luoyanglutu-pixel/SimpleKVM/硬件设计/10_软件方案.md

# 软件方案入口

2026-10-29：硬件发布基线更新为`ProPrj_SimpleKVM_2026-10-29.epro2`、`SCH_SCH_new_2026-10-29.pdf`和同日期BOM。LED、按键、CH444G控制脚及H1下载接口与既有固件映射一致；新增硬件文件没有同版本ENET，因此本次只完成PDF目视复核，未重新生成固件硬件哈希。

请阅读[软件方案 S1.0](../软件设计/01_软件方案.md)。固件按该文档实现，包括实际GPIO、四键消抖、先断后接、默认电脑4、DEV/RELEASE看门狗策略、烧录与样板验收。

旧S0.1草案未收入开源发布包。固件v0.1.1已实现并完成电脑端逻辑测试、交叉编译；请读[源码与烧录包入口](../软件设计/README.md)。5块硬件样机现均恢复基本功能，但具体固件版本、USB兼容性和长期运行仍按软件测试记录逐项验收。
