luoyanglutu-pixel/SimpleKVM/硬件设计/11_原理图复查_2026-10-20-2.md

# 更新原理图复查报告（-2版本）

> 历史报告：本文记录2026-10-20的“-2”版本，文件名和正文保留用于追溯。当前发布依据已更新为本目录中的`ProPrj_SimpleKVM_2026-10-29.epro2`、`SCH_SCH_new_2026-10-29.pdf`和同日期BOM；器件数量、DNP状态和物料结论以[README](README.md)及[05_参考资料与版本.md](05_参考资料与版本.md)为准。

历史版本V0.7；日期2026-10-20。当时接线基线为`SCH_SCH_new_2026-10-20-2.pdf`和`Netlist_SCH_new_2026-10-20-2.enet`，这两个历史输入未收入当前扁平目录。

## 1. 结论

上轮发现的选择线短接和SW2/SW4映射问题均已修正。本轮对三页PDF进行目视核对，对导出网表执行79项结构检查，全部通过，未发现同类硬连接错误。可以以此版本继续PCB设计与固件开发；打样前还应处理下列物料和电源确认项，当前不等于投产或USB认证通过。

## 2. 已修正项

| 上轮问题 | 新版实际状态 | 结论 |
| --- | --- | --- |
| U8.16/17都接MUX_SEL0 | U8.16 PC6→MUX_SEL0→KEY1.14；U8.17 PC7→MUX_SEL1→KEY1.2 | 已修正，选择信号分离 |
| SW2与SW4对应顺序错 | PD3/PD4/PD5/PD6依次接SW1/2/3/4 | 已修正 |
| 公共5V重复四颗10uF | C6/C8/C14删除，C4保留 | 公共直接标称电容41.3uF降为11.3uF |
| 四颗外部按键上拉可省 | R1～R4属性Add into BOM=no，PDF为灰色 | 默认不装，软件必须内部上拉 |

## 3. 待处理与验证

| 优先级 | 项目及证据 | 建议 / 验收条件 |
| --- | --- | --- |
| P1，打样前收敛 | F1～F4仍SMD0603-050-16，恢复电阻上限0.8Ω；Hub内部LDO要求V5≥4.5V | 以实际负载和低输入测PTC/CH213K压降，必要时选低阻PTC；不能用MCU能运行代替Hub电源达标 |
| P2，建议改图 | U6.15 V5本地C2仍100nF，已读手册引脚表建议外接1uF | 优先同位号改为1uF并靠近15脚，无需新增位号；当前图未代改 |
| P2，采购前完成 | 现有XLSX仍是旧图，保留C6/C8/C14和R1～R4装配项 | 从“-2”源工程重新导BOM；03已给新版网表提取清单供核对 |
| P2，物料确认 | 五颗10uF无完整制造商料号；X1为12MHz/CL20pF | 补齐电容耐压/介质/有效容量；实测晶体起振和频偏，默认不盲加外部电容 |
| P2，打样验证 | 四输入各10uF+公共11.3uF+Hub内部3.3V电容及外设负载 | 一路首次插入会承担本路与公共侧充电；删掉重复电容后仍需测浪涌与电源跌落 |
| P3，文档一致性 | CH444G位号KEY1；图中真值表写J1～J4，实际插座USB1～USB4 | 可规范IC位号，至少把注释连接器编号改成实际位号，避免装配/调试误认 |

PTC预算示例：300mA×0.8Ω=0.24V，加CH213K在300mA下最大压降0.08V，共0.32V。若PTC前4.75V，则公共约4.43V，尚未计走线。这是历史条件性预算，不能写成典型冷态压降或已测失败。当前保险丝料号、样机故障结论和工艺要求见[03_BOM与打样验收.md](03_BOM与打样验收.md)。

## 4. 已核对的其余关键连接

USB-C每口独立双5.1k Rd、D+/D−翻面引脚并接正确；四路VBUS逐路PTC+CH213K隔离；CH444G与Hub的上游D+/D−对应正确；三个USB-A通道及极性正确。MCU、MUX用5V，Hub VDD33独立；EN#有上拉、两个选择位有下拉；SWIO和NRST可接H1；四LED阴极接GPIO、阳极经各4.7k到5V。U6 EP库编号17接地，仍须PCB确认焊盘映射。HubRESET#/CDP、PGANG与未用第四口保持NC。

H1实际顺序为1=SWIO、2=NRST、3=GND；已同步替换旧文档的J8脚序。R1～R4按DNP处理，不能因在网表存在就统计为装配件。该历史版共59个位号、54个非空网络、55个装配件。

## 5. 已确认的成本选择及边界

按用户要求不加入数据ESD或专用电源开关，不将这两项作为本轮新增强制整改。正常按键切换只断数据，保留外设供电；源拔除和欠压仍可能复位。多电脑USB合路取电的授权/挂起行为、Hub供电属性以及外设电压要求尚未通过系统验收，现有硬件没有软件断电接口。

## 6. 可复核证据和下一步

- [当前原理图PDF](SCH_SCH_new_2026-10-29.pdf)和[当前BOM](BOM_SimpleKVM_new_SCH_new_2026-10-29.xlsx)：2026-10-29发布输入。
- [当前可编辑工程](ProPrj_SimpleKVM_2026-10-29.epro2)：包含原理图和PCB。
- [参考版本和哈希](05_参考资料与版本.md)：区分当前文件与历史检查。
- [软件方案](10_软件方案.md)：当前GPIO、按键、时序与烧录入口。

2026-10-29更新：当前目录已提供EDA工程、PCB和完整BOM，5块样机现均恢复基本功能；本文的79项脚本检查仍只对应历史网表，不能作为10月29日工程的ERC、DRC或自动连接检查结果。
