luoyanglutu-pixel/SimpleKVM/硬件设计/12_投板前审查与方案复核_2026-10-21.md

# 投板前审查与整个方案复核

> 历史报告：本文正文对应2026-10-21上午版，保留用于追溯当时的风险判断。当前发布依据为本目录2026-10-29的`.epro2`、PDF和BOM；当前物料、装配数量和样机状态以[README](README.md)、[03_BOM与打样验收.md](03_BOM与打样验收.md)及[05_参考资料与版本.md](05_参考资料与版本.md)为准。

> 后续更新：本报告对应10:47版。15:00新增Type-C的图纸审查见[13号报告](13_原理图复查_2026-10-21-2.md)。经后续讨论，主机VBUS检测按极简首版待验证的兼容性取舍记录，不再作为正常带电电脑之间按键切换的打样硬性前提；下文保留上午审查原文。该断电场景仍未由现有电路自动处理。

日期：2026-10-21。审查基线为今天10:47导出的三页原理图PDF、enet网表与BOM。用户明确“PCB我自己看”，因此本报告只对原理图连接、器件/装配信息和系统方案给结论，PCB检查由用户负责。

## 1. 投板结论

**建议先补选中电脑VBUS检测的设计/预留，并确定七颗10uF的实际物料及初装电容策略，再投第一轮功能样板。当前图没有发现上轮那类硬连接错误，但还不能按“任意电脑开关机、任意插拔均可靠”的定版电路放行。**

如果现在按原图打少量板，只能作为受控条件下的验证样机：使用已确认的5V主机端口和低功耗键鼠，先烧固件，不把数据切到VBUS已关闭的电脑，保留飞线/改件条件。这个限制不是现有固件能够自动保证的。

179项脚本检查全部通过，检查内容包括实际逐脚连接、差分对定义、BOM数量和逐位号型号一致性；另行检查的**物料完整性未通过**，因为C4/C5/C7/C9/C10/C14/C15七颗10uF没有具体制造商料号。脚本通过不等于原生ERC、实板电气或USB系统合规通过。

## 2. 今天已经修正或确认的部分

| 项目 | 当前实际状态 | 审查结论 |
| --- | --- | --- |
| F1～F4 | JK-SMD0603-050L-6，C5224376，500mA保持/1A动作，6V | 已落实国产低阻版本，接线方向未变 |
| U6 V5去耦 | C2改为1uF，接SYS_5V到GND | 上轮建议已落实；就近摆放由PCB确认 |
| 选择控制 | PC6.16→MUX_SEL0→KEY1.14；PC7.17→MUX_SEL1→KEY1.2；PD2.19→KEY1.1 EN# | 两位选择信号独立，未再出现同网短接 |
| 按键 | PD3.20、PD4.1、PD5.2、PD6.3依次接SW1～SW4 | 顺序正确；R1～R4不装，必须内部上拉 |
| LED | PC0.10～PC3.13对应LED1～LED4阴极，阳极各经4.7k到5V | 低亮高灭，正常只亮一个 |
| H1 | 1=SWIO/PD1.18；2=NRST/PD7.4；3=GND | 正确，不能套旧草稿J8线序 |
| Hub供电 | U6.15=SYS_5V；U6.16=HUB_VDD33；EP库脚17=GND | 5V和内部3.3V分离正确；EP实物映射由PCB确认 |
| Hub时钟 | X1接XI/XO，C6/C8各12pF但标DNP | 默认不装外部晶体电容，符合已读应用图原则 |
| USB-C | 每口CC1/CC2各有独立5.1k；A6/B6合D+，A7/B7合D−；四路原始VBUS独立 | 连接正确 |
| 数据通道 | 四路USB-C→CH444G→CH334P→USB5/6/7 | D+/D−极性、通道顺序正确 |
| 数据网络命名 | HUB_UP_DP/DM改为HUB_UP_D+/D−，两个端点同时修改 | 改名没有造成断网；8组差分对已定义 |
| BOM版本 | 今天XLSX与今天网表的装配集合一致 | 64个位号，58个装配件，6个DNP |

六个默认不装位号为**R1/R2/R3/R4、C6/C8**。C6/C8现在是晶体微调电容，不是昨天被删的公共10uF，不能按旧位号直接套用昨天的装配意见。USB7当前仍为装配件，第三下游口同样直供SYS_5V。

## 3. P1：选中电脑VBUS消失时，没有数据断开机制

### 具体触发条件

电脑A继续给本板供电；数据开关选在电脑B；电脑B关机且该USB口VBUS关闭，或者该口被主机切断供电。本板仍由A供电，Hub内部上拉/PHY仍有电，MCU也仍保持EN#低，数据通路继续连到B。

CH213K只隔离VBUS电源通路，不能隔离当前选中的D+/D−。因此存在对未供电主机数据口继续施加电压/电流的风险，具体回灌和异常程度取决于主机端电路，不能断言必然损坏，也不能认为“有理想二极管就已经全部防反灌”。这也是为何带其它电源来源的USB设备需要判断上游VBUS是否存在。[原厂USB设计指南关于VBUS检测的说明](https://www.silabs.com/documents/public/user-guides/UG225.pdf)

这里的判断条件是**所选端口VBUS是否存在**，不是电脑操作系统是否运行。部分电脑关机后仍保留USB 5V，VBUS检测无法区分这种待机与正常开机，也不必把待机5V误当成0V。

### 建议的最小改动方向

恢复4路独立的VBUS存在检测，信号从各自USB-C原始PC0_VBUS～PC3_VBUS引入，不能从公共SYS_5V取样，否则无法区分电脑。当前可利用U8的空闲PA1.5、PA2.6、PC4.14、PC5.15分别检测电脑1～4，保留PD1下载和PD7复位。

每路可用分压/隔离检测网络，优先预留两电阻焊盘；具体阻值必须按5V MCU的输入阈值、漏电、输入电容放电以及MCU未上电时的注入电流核算，不直接照搬3.3V MCU分压值。PA1/PA2必须关闭HSE并正确配置为GPIO，不能把Hub晶体X1误当作MCU时钟。若分压方案的断电注入或检测余量不满足，再使用小三极管隔离检测。

配套固件规则：默认EN#高；选中目标VBUS不存在就保持全断开；运行中检测到目标VBUS丢失优先拉高EN#；恢复后确认稳定，再按先断后选流程接通。用户请求的target可以保留等待，不自动跳到别的电脑。这个规则只负责有无VBUS，不声称是精密欠压检测。

**仅预留焊盘、不装器件且不改固件，不能算风险已经解决。** 现有10号软件方案描述的是“无VBUS检测”的原图版本；决定补检测后必须同步改输入初始化、接通条件和验收用例。

## 4. 整个供电架构仍有的边界

### 4.1 电源来源与数据主机分离

```text
数据：USB1～USB4 → KEY1四选一 → U6 Hub → USB5～USB7
供电：各USB-C → 各PTC → 各CH213K → 同一SYS_5V
控制：U8只决定数据目标；当前不决定哪个电脑供电
```

CH213K自动按电压及负载导通，没有协议意义上的电源优先级，也不是保证均流的四路并联电源。不能把四台电脑的额定电流简单相加作为整板能力。

可能由未选中、尚未枚举或已挂起的电脑端口承担主要电流。当前没有相应的USB配置/CC电流能力检测和源使能控制，所选电脑的Hub枚举也不能给其它电脑端口“代办取电授权”。Hub在所选主机挂起时进入低功耗，并不自动使MCU、LED和外设从实际供电源取电降到许可值。[USB-IF供电声明与挂起电流说明](https://compliance.usb.org/index.asp?UpdateFile=Electrical)

**补第3节VBUS检测只能解决无VBUS目标仍接数据的问题，不能完整解决取电授权和挂起电流。** 这些限制可在受控样机测试中明确记录；若目标是面向任意电脑的标准化产品，需要进一步确定供电策略，而不是靠一版软件把现有固定电源通路变成可控通路。

### 4.2 低压带载余量

按PTC规格书的R1max=0.4Ω上限预算；该厂家定义是回流后一小时测得的电阻上限，0.07Ω是初始最小值，均不能当作典型运行电阻。CH213K压降采用已读V1.1手册在相应电流下的最大值：

| 经过单路输入的整板总电流 | PTC预算压降 | CH213K最大压降（5V测试条件） | PTC前4.75V时SYS_5V估算 |
| --- | --- | --- | --- |
| 100mA | 0.040V | 0.040V | 4.670V |
| 200mA | 0.080V | 0.057V | 4.613V |
| 300mA | 0.120V | 0.080V | 4.550V |
| 500mA | 0.200V | 0.130V | 4.420V |

这是条件性预算，并非实测值，且未计PCB、接头、动态尖峰、温度和电源进一步下跌；CH213K参数是在指定5V条件下取得，不能当作所有输入电压下的保证。4.75V这里指**本板PTC前的测试电压**，不是主机端给4.75V再忽略USB线损。

CH334P启用内部LDO时，已读V2.91给出V5工作范围4.5～5.25V，因此目前不能承诺“500mA整板负载也稳定”。建议把**整板总负载≤200mA作为首轮样机的初始设计目标**，包括Hub、MCU、LED、键盘、鼠标及第三口；这不是经过验收的额定电流，实际允许负载以最低输入、温升和外设VBUS测试结果为准。RGB键盘、充电或大电流扩展设备不能默认支持。

PTC还会随温度降额：所选厂家表中，500mA型号在60℃/85℃的保持电流分别约340mA/210mA。需按壳内温度验证，不能把常温保持500mA当作全温恒定能力。[JK低阻系列厂家资料](https://datasheet.lcsc.com/lcsc/2210281800_Jinrui-Electronic-Materials-Co--JK-SMD0603-050L-6_C5224376.pdf)

### 4.3 多源短路不会保证四颗PTC都断开

CH213K不是没有保护：它有约1.3A典型过流限流，并在输出短路后折返到典型250mA、规格180～330mA（V1.1、25℃、5V测试条件）。单路折返电流可能低于PTC的500mA保持值，PTC不一定动作；四路都参与短路时，条件性合计约0.72～1.32A，实际还受源能力、温升和热关断影响。

因此不能宣称每个USB-A具有500mA独立限流、能识别故障口或能由固件关断。一个USB-A短路会拖低整个公共电源，Hub和MCU都可能复位。按用户极简成本选择，本报告不恢复TPS2553或数据ESD为默认件，但上述故障边界必须实测并明确保留。

### 4.4 输入上限也要确认

已读CH334 V2.91的V5推荐工作上限5.25V、绝对最大值5.5V。USB-IF的VBUS上限ECN允许到5.5V，低阻CH213K在轻载时不能把5.5V可靠降到5.25V。这里是**工作范围待厂家确认项**，不是断言会立即烧毁。[USB-IF上限更新](https://compliance.usb.org/index.asp?UpdateFile=Electrical)

本轮重新查询WCH官网，确有CH334DS1 V3.0（2026-10-19）元数据，但官方直接下载返回“请刷新页面后再重试”，未取得新版正文；不把旧版参数冒充新版结论。受控样机先用已确认的输入；产品化前应向厂家确认采购批次的实际输入工作范围，或采用能覆盖输入范围的供电方案。

## 5. 电容、BOM及装配

### 5.1 当前电容实际汇总

| 电源网络 | 当前电容 | 标称总量 |
| --- | --- | --- |
| SYS_5V | C4/C14/C15各10uF；C2/C13/C16各1uF；C3/C11各100nF | 33.2uF |
| PC0输入，PTC后/CH213K前 | C10 | 10uF |
| PC1输入，PTC后/CH213K前 | C5 | 10uF |
| PC2输入，PTC后/CH213K前 | C7 | 10uF |
| PC3输入，PTC后/CH213K前 | C9 | 10uF |
| HUB_VDD33 | C1=10uF、C12=1uF | 11uF |

第一次仅插一路供电，会给本路10uF、公共33.2uF、Hub内部3.3V电容和外设充电。其它三路输入电容因CH213K反向隔离，不能简单算成也同时被公共5V充电。LDO两侧电容也不能直接按电压相同的并联电容求和。

CH213K自身能承受一定负载电容，不等于上游USB浪涌自动合格；新增公共电容能改善瞬态保持，也会增加启动充电负担，需看实际电流波形。

建议首样把C14/C15保留焊盘、先标DNP作容量调整选项，C4保留10uF，C2/C13/C16及C3/C11按本地去耦装配，此时公共标称13.2uF。先测启动和外设热插拔，再决定加装C14/C15。**这是建议装配策略，当前原图仍把二者标为装配，不得口头省掉却不改BOM。** 它也不代表仅靠减电容就已经通过USB浪涌要求。

### 5.2 七颗10uF缺具体物料

C4/C5/C7/C9/C10/C14/C15目前只有10uF、0603，没有制造商、完整型号、耐压、介质和容差，不能把这份BOM直接交给贴片厂自行代选。选定实际料号；若用于5V，建议评估≥10V、X5R/X7R，并确认直流偏压后的有效容量及封装。C14/C15若改DNP，也仍建议给出备选料，避免后续补装混料。

C1已经选为HRE CGA0402X5R106M6R3GT，10uF/6.3V/0402，接3.3V；不能因前缀CGA就误认为TDK。C12是1uF/16V，当前两者合计11uF，未发现接错电源。0402大容量同样需关注有效容量，不能以10uF标称值代替实测。

## 6. 晶体选型和预留电容

X1目前仍为**X49SD12MSD2SC，12MHz、CL20pF、ESR50Ω、-20～70℃**，不是12pF版本。C6/C8是各12pF的DNP调试位，默认不装，方向正确。

此前倾向选CL12pF，是依据内置电容与杂散的简化模型作的选型建议，并非CH334P官方给出的兼容晶体名单，也不能据此判定现有20pF一定不能工作。当前没有晶体动参数、板级杂散、起振波形和频偏测试，结论只能是待验证。

不要因为晶体标20pF，就把C6/C8改成各20pF并默认装上；不要因为采购CL12pF晶体，就把两颗12pF预留件默认焊上。已读CH334应用说明建议不装外部振荡电容。只有按实际频偏和起振结果调整时才改变装配值，采购必须锁定具体负载规格。若产品要承诺-40～85℃，当前X1的-20～70℃范围也不覆盖，需要换对应温度等级，而不是只看MCU/Hub工业温度。

## 7. 方案功能与软件再确认

- 每台电脑一根USB数据线，四选一接入同一个Hub；三只USB-A当前都提供公共5V。键盘和鼠标会在新主机重新枚举，不是四主机同时在线的HID仿真设备。
- 当前无键盘热键切换、无纯蓝牙配对、无视频切换；2.4G USB接收器按型号验证。USB蓝牙适配器切换涉及电脑驱动和配对状态，不能等同于直接支持所有蓝牙键鼠。
- MCU使用内部HSI；Hub的X1不供MCU使用。PD5/PD6已接按键，禁用示例默认USART打印，保留PD1调试和PD7复位。
- R1～R4不装，PD3～PD6必须上拉输入；20ms消抖，一次按住只触发一次，多键序列等全部释放后再接收。
- 先写EN#高、LED全灭和选择00的锁存值，再配置输出；切换先断数据，名义100ms后写选择位，名义1ms稳定后接通。毫秒节拍有量化误差，不能把名义时间当硬件严格下限。
- 任何时刻LED只表示数据目标，不能表示USB枚举成功；加VBUS检测后，目标无VBUS时保持断开，LED需明确区分等待状态。
- 空片在EN#外部上拉作用下默认全部数据断开，**必须先烧MCU程序，才会看到Hub正常连入电脑**。USB不枚举时不要先把这个默认安全态当作接线错误。
- H1接WCH-LinkE的SWDIO/TMS、RST（可选）、GND；板子自行5V供电时，下载器5V/3V3输出均不接。ST-Link、J-Link V8和普通USB-TTL不能按现有流程直接代替。

## 8. 投第一轮样板前建议完成的最少事项

1. 决定并落实第3节的四路VBUS检测接口或至少便于改版的焊盘/引线位置；未经实现和测试前，只按受控验证样机使用。
2. 锁定七颗10uF料号，以及C14/C15是否默认DNP；明确C6/C8、R1～R4不装，避免贴片厂全装。
3. 固定采购X1的CL与温度等级，保留调试位；不要把负载规格与外接电容值混淆。
4. 整板负载按低功耗键鼠定位；先用≤200mA总负载作样机目标，不承诺第三口充电或每口500mA。
5. 由用户完成原生ERC/PCB检查与生产文件确认。当前导出网表定义了8组差分对，但未给它们绑定专用规则；这不能证明PCB已经按90Ω布好。双层1.6mm、1oz的0.28mm线宽/0.15mm线距/0.15mm同层铺地间距仅为前述参考案例，仍按板厂实际结构确认。本报告不重复要求用户提交PCB。

## 9. 样板回来后的关键验证

| 场景 | 必测内容 / 通过条件 |
| --- | --- |
| 单路最低电压带载 | PTC前4.75V；总电流100/200/300mA分档；测U6 V5、VDD33、USB-A端电压与温升。4.5V只是Hub的最低工作值，外设电压也需合格 |
| 500mA探索档 | 仅台架探索，不作为已保证的工作额定；确认是否欠压或PTC温升动作 |
| 首次插入与多源拔插 | 带/不带键鼠插入，抓输入电流和SYS_5V最低点；只拔掉主要供电源且仍有其它输入时不得异常复位 |
| A供电、B无VBUS | 关闭B端VBUS但保留数据连接；观察EN#及D+/D−，确认补检测后通路实际断开，检查B口是否受电 |
| 各主机睡眠/唤醒 | 分别测每一路电脑输入电流，而不是仅测总电流；记录供电来源与数据目标不一致时的行为 |
| 多输入短路 | 限流电源台架、受控条件下逐步测试，不先用四台电脑当短路电源；确认折返电流、温升、全部公共供电掉电及恢复行为 |
| 四通道切换 | 所有12个有向切换组合，键盘+鼠标同时接，累计至少100次；确认仅目标主机识别、按键不连发、无中间误通 |
| 晶体与外设兼容 | 测冷/热启动和频偏，避免普通大电容探头扰振；记录有线键鼠、接收器、BIOS/系统及线材型号，Type-C两种方向均验证 |
| 反向供电 | 同时测未供电输入的VBUS和所选未供电主机的数据线，不把测完VBUS就等同于全部防反灌通过 |

## 10. 输入、证据和版本

| 原始输入 | SHA-256 |
| --- | --- |
| `SCH_SCH_new_2026-10-21.pdf`（历史10:47版，发布包未收录） | `56f35b37c3b4456cb39b8ed90363ab9fe9f384a6e4081a01c73770480408a060` |
| `Netlist_SCH_new_2026-10-21.enet`（历史10:47版，发布包未收录） | `09a54218a19713226b62612a7be57d9fdd1842a46c87a3337d1769538bdfac52` |
| `BOM_SimpleKVM_new_SCH_new_2026-10-21.xlsx`（历史10:47版，发布包未收录） | `99992025ffda80f9c54d54df6f69f16dc4ad522f2ecfe116fece7ac18d0286a0` |

本节记录的是历史10:47版审查输入。当前目录已改为2026-10-29扁平发布结构；历史数量不得用于当前采购。当前原理图为67个位号、60个默认装配器件和7个DNP，详见03和05号文档。

本地手册依据：CH334DS1 V2.91第3页功能对比、第19页电气、第26页振荡与应用；CH213DS1 V1.1第2～3页方向和电气、第5页启动；CH32V003DS0 V1.0第9页脚号、第13/19页输入与注入限制；CH440DS1 3E的CH444G引脚和真值表。当前发布包不再包含历史审查附件，采购前应从原厂重新取得适用版本。

本文只作为历史记录。2026-10-29版保持软件核心GPIO不变，已提供PCB工程和完整BOM，5块样机现均恢复基本功能；仍未完成USB认证、ESD/EMC和批量一致性验证。
