luoyanglutu-pixel/SimpleKVM/docs/版本与资料范围.md

# 版本与资料范围

开源包整理日期：2026-10-29。

## 发布基线

| 模块 | 基线 |
| --- | --- |
| 硬件连接 | `SCH_SCH_new_2026-10-29.pdf`与同日期BOM |
| 可编辑EDA工程 | `ProPrj_SimpleKVM_2026-10-29.epro2`，嘉立创EDA专业版4.1.78，含3页原理图和1块PCB |
| 固件 | v0.1.1，默认PC4/LED4 |
| MCU | CH32V003F4P6 |
| USB数据开关 | CH444G |
| USB Hub | CH334P |
| 结构 | 当前目录现有SolidWorks、STL和3MF集合 |

## 网表与历史审查资料

当前目录没有2026-10-29版ENET网表。`04_引脚连接清单.json`以及11～13号审查报告记录的是2026-10-20至21日的历史基线，只用于追溯，不能代替当前工程重新导出的网表。

当前关键GPIO、USB端口和主要电源连接已按10月29日PDF目视复核。复刻或修改设计时，应从当前`.epro2`工程重新导出同版本网表、Gerber、钻孔和贴片坐标，并重新执行ERC/DRC及固件映射检查。

当前发布文件的逐文件哈希见仓库根目录`SHA256SUMS.txt`。哈希只能用于确认文件内容是否改变，不等于已在嘉立创EDA中完成导入、ERC或DRC。

## 验证边界

- 固件23项主机端逻辑测试通过。
- 三种固件配置交叉编译通过。
- 历史原理图导出网表与固件GPIO掩码检查通过；该结论不自动覆盖10月29日版工程。
- `.epro2`归档包含3页原理图和1块PCB；发布前仍应在嘉立创EDA专业版中打开并运行ERC/DRC。
- 5块样机均已恢复基本功能；此前3块异常确认与回流焊后0603自恢复保险丝损坏、阻值异常有关。
- 上述检查不等于PCB DRC、USB协议兼容性、阻抗、ESD、EMC、温升或批量生产验证。
