luoyanglutu-pixel/SimpleKVM/硬件设计/02_原理图设计指导.md

# 原理图设计指导与接线基线

版本V1.0；更新日期2026-10-29。接线基线为`SCH_SCH_new_2026-10-29.pdf`，可编辑工程为`ProPrj_SimpleKVM_2026-10-29.epro2`。

当前目录没有同版本ENET网表。以下内容来自三页PDF目视核对；`04_引脚连接清单.json`是2026-10-20历史导出，不能作为10月29日工程的自动校验结果。

## 1. 四个电脑侧USB-C输入

USB1～USB4分别对应电脑1～4和内部PC0～PC3。每个接口的A6/B6并到本口D+，A7/B7并到本口D−，A4/A9/B4/B9并到本口VBUS。CC1和CC2各用独立5.1kΩ下拉电阻，位号为R13～R20；两个CC脚不能短接。

四路电源按下表进入SYS_5V：

| 电脑 / 接口 | 原始VBUS | 保险丝 | CH213K | 输入侧10uF |
| --- | --- | --- | --- | --- |
| 电脑1 / USB1 | PC0_VBUS | F1 | U2 | C10 |
| 电脑2 / USB2 | PC1_VBUS | F2 | U1 | C5 |
| 电脑3 / USB3 | PC2_VBUS | F3 | U3 | C7 |
| 电脑4 / USB4 | PC3_VBUS | F4 | U4 | C9 |

每路由电脑VBUS经过保险丝进入CH213K的VI+，CH213K的VO−汇合到SYS_5V，1脚接GND。VO−是器件库中的引脚名称，不表示该脚接地。

当前数据线直接进入CH444G，没有默认串联电阻和专用ESD器件。这是极简成本版本的明确边界；普通小电阻不能替代ESD钳位。

## 2. KEY1：CH444G

| 脚号 | 名称 | 当前网络 |
| --- | --- | --- |
| 1 | EN# | MUX_EN_N |
| 2 | IN1 | MUX_SEL1 |
| 3 | S4A | PC3_D+ |
| 4 | S3A | PC2_D+ |
| 5 | S2A | PC1_D+ |
| 6 | S1A | PC0_D+ |
| 7 | YA | HUB_UP_D+ |
| 8 | GND | GND |
| 9 | YB | HUB_UP_D− |
| 10 | S1B | PC0_D− |
| 11 | S2B | PC1_D− |
| 12 | S3B | PC2_D− |
| 13 | S4B | PC3_D− |
| 14 | IN0 | MUX_SEL0 |
| 15 | NC | 不连接 |
| 16 | VCC | SYS_5V |

R9=10kΩ将EN#上拉到SYS_5V；R10、R11各100kΩ，将SEL0、SEL1下拉到GND。C11=100nF贴近KEY1供电脚。切换时先将EN#拉高，更新IN1/IN0，等待稳定后再拉低EN#。

| 目标电脑 | EN# | IN1 | IN0 | 上游接口 |
| --- | --- | --- | --- | --- |
| 电脑1 | 0 | 0 | 0 | USB1 |
| 电脑2 | 0 | 0 | 1 | USB2 |
| 电脑3 | 0 | 1 | 0 | USB3 |
| 电脑4 | 0 | 1 | 1 | USB4 |
| 全断开 | 1 | 任意 | 任意 | 只断数据，不断SYS_5V |

## 3. U6：CH334P四口Hub

| U6脚号 | 名称 | 网络 / 用途 |
| --- | --- | --- |
| 1 / 2 | XO / XI | X1 12MHz晶体 |
| 3 / 4 | DM4 / DP4 | HD3_D− / HD3_D+，到USB7 |
| 5 / 6 | DM3 / DP3 | HD2_D− / HD2_D+，到USB6 |
| 7 / 8 | DM2 / DP2 | HD1_D− / HD1_D+，到USB5 |
| 9 / 10 | DM1 / DP1 | HD0_D− / HD0_D+，到USB8 |
| 11 / 12 | DMU / DPU | HUB_UP_D− / HUB_UP_D+，来自CH444G |
| 13 | RESET#/CDP | 不连接 |
| 14 | PGANG | 不连接 |
| 15 | V5 | SYS_5V，C2=1uF到地 |
| 16 | VDD33 | HUB_VDD33，C12=1uF到地 |
| 17 / EP | GND | 必须在PCB封装中可靠接地 |

X1为12MHz、HC-49US封装，当前料号`X49SD12MSD2SC`。C6、C8标注12pF但默认不装，使用CH334P内部振荡负载。若更换晶体，应重新核对负载电容、起振裕量和频偏，不能只按频率替换。

C1=10uF作为Hub附近SYS_5V电容；C2和C12均为1uF。HUB_VDD33是CH334P内部LDO输出，不连接SYS_5V，也不用于给MCU供电。

## 4. 四个下游接口

| Hub端口 | U6数据脚 | 网络 | 外部接口 | VBUS |
| --- | --- | --- | --- | --- |
| 第1路 | 9 DM1 / 10 DP1 | HD0_D− / HD0_D+ | USB8 Type-C | SYS_5V常供电 |
| 第2路 | 7 DM2 / 8 DP2 | HD1_D− / HD1_D+ | USB5 Type-A | SYS_5V |
| 第3路 | 5 DM3 / 6 DP3 | HD2_D− / HD2_D+ | USB6 Type-A | SYS_5V |
| 第4路 | 3 DM4 / 4 DP4 | HD3_D− / HD3_D+ | USB7 Type-A | SYS_5V |

USB8的A6/B6并为D+，A7/B7并为D−。CC1、CC2分别通过R21、R22各56kΩ上拉SYS_5V，表示默认USB电流档。USB8没有CC检测和VBUS开关，因此只作为已知低功耗USB2.0外设口使用；不要连接另一台电脑、供电扩展坞或其它可能向VBUS反向供电的设备。

USB5～USB7的2脚为D−、3脚为D+、4脚及外壳脚接GND。四个下游口可同时插外设，但共享同一个SYS_5V电源预算。

## 5. U8：CH32V003F4P6

| 功能 | GPIO | 芯片脚号 | 网络 | 说明 |
| --- | --- | --- | --- | --- |
| LED1～LED4 | PC0～PC3 | 10～13 | PC0_LED～PC3_LED | 低电平点亮 |
| SW1～SW4 | PD3～PD6 | 20、1、2、3 | PC0_SWI～PC3_SWI | 内部上拉，按下接地 |
| MUX_SEL0 | PC6 | 16 | MUX_SEL0 | CH444G IN0 |
| MUX_SEL1 | PC7 | 17 | MUX_SEL1 | CH444G IN1 |
| MUX_EN_N | PD2 | 19 | MUX_EN_N | CH444G EN# |
| SWIO | PD1 | 18 | SWIO | 单线下载 |
| NRST | PD7 | 4 | NRST | R12=10kΩ上拉 |
| 电源 | VDD / VSS | 9 / 7 | SYS_5V / GND | MCU直接使用5V |

C3=100nF、C13=1uF为MCU供电去耦，C15=10uF保留但默认不装。R1～R4为外部按键上拉预留，默认不装；固件必须开启PD3～PD6内部上拉。R5～R8各4.7kΩ，从SYS_5V经LED接到PC0～PC3，GPIO低电平点亮。

固件使用内部HSI，不使用板上X1。保留PD1调试和PD7复位功能，不要启用占用PD5/PD6的串口打印初始化。

## 6. H1下载接口

| H1脚号 | 网络 | MCU | WCH-LinkE |
| --- | --- | --- | --- |
| 1 | SWIO | PD1 / 18脚 | SWDIO/TMS |
| 2 | NRST | PD7 / 4脚 | RST，可选 |
| 3 | GND | VSS / 7脚 | GND |

目标板由USB或限流5V电源供电时，不连接WCH-LinkE的3.3V或5V输出，也不连接SWCLK。H1不是下载器排针的物理直通定义，必须按网络名接线。烧录步骤见[08_下载接口与烧录指南.md](08_下载接口与烧录指南.md)。

## 7. PCB与生产检查

- 在嘉立创EDA专业版中执行ERC和DRC，确认U6 EP、U8、KEY1和所有USB连接器的1脚方向与封装。
- USB 2.0差分对按板厂叠层计算约90Ω差分阻抗，连续参考地、成对、短、少过孔，不跨地缝。
- CH444G至U6的上游对以及4个电脑支路避免长支线；X1靠近U6并远离USB和控制走线。
- PTC和CH213K电源铜皮按实际电流、压降和温升设计。F1～F4回流后必须测量冷态阻值。
- 当前目录没有Gerber、钻孔、贴片坐标和同版本ENET网表；不能仅凭PDF完成生产放行。

物料和实板测试见[03_BOM与打样验收.md](03_BOM与打样验收.md)。
