luoyanglutu-pixel/SimpleKVM/硬件设计/05_参考资料与版本.md

# 参考资料与版本记录

版本V1.0；更新日期2026-10-29。

## 1. 当前发布输入

| 文件 | 用途 | SHA-256 |
| --- | --- | --- |
| [ProPrj_SimpleKVM_2026-10-29.epro2](ProPrj_SimpleKVM_2026-10-29.epro2) | 嘉立创EDA专业版4.1.78可编辑工程，含SCH、3个SCH_PAGE和PCB | `e9788795cc1f5868b95208a61531f9a7a6e04f5df2975a7832593e5f73e33620` |
| [SCH_SCH_new_2026-10-29.pdf](SCH_SCH_new_2026-10-29.pdf) | 三页原理图PDF | `2a0472c722191a3ec380d78114c99a1b42fed6ea0d62099289b459ac37409519` |
| [BOM_SimpleKVM_new_SCH_new_2026-10-29.xlsx](BOM_SimpleKVM_new_SCH_new_2026-10-29.xlsx) | 20个物料行、60个默认装配器件 | `8ed492aca8bc979d2edb6fc583e5668d9446db59df8c7a54627b02a527e63dc3` |

PDF文件于2026-10-29导出，但图框中的创建/更新日期仍显示2026-10-21或2026-10-22。该图框日期没有随导出更新，不能单独用来判断发布版本；公开发布以文件名、文件哈希和本记录为准。

当前目录没有2026-10-29同版本ENET网表。`04_引脚连接清单.json`以及11～13号报告属于2026-10-20至21日历史审查资料。当前GPIO、USB端口和主要电源连接已按新PDF目视复核，但没有对新版工程重新执行网表脚本检查，也没有在本轮通过嘉立创EDA图形界面重新运行ERC/DRC。

## 2. 当前物料与装配变化

- 4路保险丝明确为`JK-SMD0603-050L-6`，商城编号C5224376。
- 7颗默认装配10uF电容均已有具体制造商料号；C1为0402，其余C4、C5、C7、C9、C10、C14为0603。
- C2已为1uF，C12、C13、C16同为1uF。
- R21、R22为56kΩ，用于USB8 Type-C的CC1/CC2上拉。
- R1～R4、C6、C8、C15共7项默认不装。
- BOM总数为20个物料行、60个默认装配器件；原理图共67个位号。

## 3. 原厂资料入口

- [CH334手册](https://www.wch.cn/downloads/CH334DS1_PDF.html)：Hub引脚、电源、振荡器和应用电路。
- [CH440系列手册](https://www.wch.cn/downloads/CH440DS1_PDF.html)：CH444G引脚和选择真值表。
- [CH213手册](https://www.wch.cn/downloads/CH213DS1_PDF.html)：电源方向、压降和工作条件。
- [CH32V003资料](https://www.wch.cn/products/CH32V003.html)：TSSOP20脚号、5V供电和GPIO参数。
- [WCH-Link产品页](https://www.wch.cn/products/wch-link)：下载器型号和支持范围。
- [WCH-LinkUtility](https://www.wch.cn/downloads/WCH-LinkUtility_ZIP.html)：固件下载工具。

第三方数据手册未随本目录重新分发。采购、替代料和量产前应从原厂获取与实际型号、批次相符的最新手册，不应只依赖历史审查中的旧版页码。

## 4. 固件依据

固件使用CH32V003F4P6、内部HSI和PD1/SWIO单线下载。应用代码、固定WCH SDK来源、构建和测试记录位于相邻的`软件设计`目录。当前10月29日原理图保持以下核心映射：

- PC0～PC3：LED1～LED4，低电平点亮；
- PD3～PD6：SW1～SW4，内部上拉；
- PC6、PC7、PD2：MUX_SEL0、MUX_SEL1、MUX_EN_N；
- PD1、PD7：SWIO、NRST。

由于当前未导出同版本ENET，固件硬件校验脚本仍只证明历史网表基线；发布前如修改上述映射，应先导出新版网表并更新校验哈希。

## 5. 历史文件说明

11、12、13号Markdown保留早期审查过程和设计取舍，用于追溯，不是当前采购或生产依据。若历史报告中的器件数量、DNP状态、电容料号或输入文件与本文件冲突，以2026-10-29的`.epro2`、PDF、BOM和本记录为准。
