luoyanglutu-pixel/SimpleKVM/硬件设计/13_原理图复查_2026-10-21-2.md

# 2026-10-21下午版原理图复查

> 历史报告：本文记录2026-10-21下午版及当时的BOM统计。当前发布依据为本目录中的2026-10-29`.epro2`、PDF和BOM；当前为67个位号、60个默认装配器件、7个DNP。下文保留用于追溯Type-C下游口的设计过程，不作为当前采购清单。

历史审查对象：15:00导出的`SCH_SCH_new_2026-10-21-2.pdf`、`Netlist_SCH_new_2026-10-21-2.enet`和同版BOM；这些历史输入未收入当前扁平目录。当时对照10:47版逐页核对三页PDF、连接和BOM，PCB不在该次结论内。

## 1. 结论

**新增Type-C的数据和CC电阻接线正确，没有发现本次修改引入的硬连接错误。** 当前为3个USB-A和1个USB-C独立下游口，不是把A/C插座并接在同一路；可以同时连接外设。四台电脑仍由CH444G选一路，再经CH334P扩展到四个外设。

本版沿用VBUS常供电的极简下游Type-C接法，没有CC接入检测、受控VBUS开关或输出反灌隔离，因此不能按完整符合Type-C要求的通用接口定版。低功耗、固定键鼠的首版验证与通用接口量产应分开判断；误接其他电源、电脑供电口或有供电功能的扩展坞，可能形成输出端电源互连。

上午报告将主机VBUS检测列为先补再打样，后续讨论已澄清：它不妨碍正常带电电脑之间的按键切换。本次按极简首版的功能边界记录，不要求为功能打样自动增加电路；目标主机断电后的数据隔离仍未实现，不代表风险已经消失。VBUS常有5V也不等于电脑操作系统已经运行。

389项连接、变更范围、装配及BOM一致性断言通过。这个数包括逐位号料号、数值、封装和供应商编码核对，不是389项电气性能测试。**物料完整性仍不通过：七颗10uF未定料号。** 未执行原生EDA ERC、PCB检查、固件编译/烧录或样板测试。

## 2. 本次实际改动

- 新增USB8，型号KH-TYPE-C-16P，供应商编码C709357，加入BOM。
- 新增R21、R22，各56kΩ、1%、0402，FRC0402F5602TS，C2906875，均加入BOM。
- U6的第4路DM4/DP4从悬空改为接USB7。原有USB5、USB6的数据各后移一组，第1路改接新USB8。
- 原有器件的有效规格、物料型号和DNP状态未改变；导出增加的PCB Layer=Default属性不视为电路改动。
- 该历史版有67个位号、61个默认装配、6个DNP、58个非空网络和9组差分对；BOM为20个物料行，包含新增插座和电阻。

## 3. 四个独立下游口的实际分配

| Hub端口 | U6 D+脚 | U6 D-脚 | 网络 | 外部插座 |
| --- | --- | --- | --- | --- |
| 第1路 | 10 DP1 | 9 DM1 | HD0_D+/HD0_D- | USB8 Type-C |
| 第2路 | 8 DP2 | 7 DM2 | HD1_D+/HD1_D- | USB5 Type-A |
| 第3路 | 6 DP3 | 5 DM3 | HD2_D+/HD2_D- | USB6 Type-A |
| 第4路 | 4 DP4 | 3 DM4 | HD3_D+/HD3_D- | USB7 Type-A |

这与先前建议“Type-C接第4路”的编号不同，但功能等效，当前连接没有问题。四个口没有并接D+/D-，没有极性反接，也没有把Type-C接到电脑上游选择通道。

## 4. USB8逐项核对

| 项目 | 实际连接 | 判断 |
| --- | --- | --- |
| D+ | A6、B6合并，HD0_D+，接U6.10 | 正确 |
| D- | A7、B7合并，HD0_D-，接U6.9 | 正确 |
| CC1 | A5经R21 56kΩ上拉SYS_5V | Source端默认电流Rp方向正确 |
| CC2 | B5经R22 56kΩ上拉SYS_5V | 独立Rp，未与CC1短接 |
| VBUS | A4/A9/B4/B9全部直接接SYS_5V | 电源脚齐全，但恒带电 |
| 地 | A1/A12/B1/B12及四个外壳脚均GND | 连接完整 |
| SBU | A8、B8悬空 | 普通USB2.0用途正确 |
| 差分定义 | HD0_D与HD3_D等9组定义齐全 | 正负网络匹配，不代替PCB阻抗检查 |

CC1/CC2各上拉56kΩ表示默认USB供电档，不是1.5A或3A。该电阻不做限流，不会增加整机的实际电流预算。SYS_5V经过保险丝和理想二极管会有压降，负载测试同时要观察Type-C供电电压；低于驱动Rp所要求的供电范围不能按标准端口宣称。

参考：[乐鑫USB Type-C硬件指南](https://docs.espressif.com/projects/esp-iot-solution/en/latest/usb/usb_overview/usb_typec_hardware_guide.html)、[TI CC控制器选型指南](https://www.ti.com/lit/an/sdaa284/sdaa284.pdf)、[TI下游Type-C VBUS控制说明](https://e2e.ti.com/support/interface-group/interface/f/interface-forum/1324014/faq-how-to-control-vbus-on-a-usb-c-port)。最后一项本轮网页读取受限，沿用前次已检索的官方说明，不作为本轮新取得的全文。

## 5. 首版保留的限制和装配事项

### 5.1 新增C口的电源角色

标准下游C口需要根据CC检测确认受电设备接入，再开启VBUS，断开后关闭；无需为了普通5V键鼠引入PD快充。当前R21/R22仅建立Rp，不能执行检测、开关或防反灌。

首版若按当前极简图制作，应将USB8标识为键鼠外设口，并在已确认的低功耗外设上验证。插座外壳标称3A只是连接器能力，不是整机输出能力。充电器、另一台电脑、手机充电负载或带供电的扩展坞不属于已验证用途。输入侧F1～F4/CH213K不等同于新增输出口的隔离开关。

若要求通用Type-C兼容性，后续应补CC检测、VBUS通断及适当的反向电流控制；本次没有选定或实际添加这些电路。

### 5.2 装配清单

- R1/R2/R3/R4、C6/C8继续DNP，当前BOM确实排除它们。按键需启用MCU内部上拉；晶体电容不应仅因晶体CL=20pF就直接装上。
- C4/C5/C7/C9/C10/C14/C15仍只有10uF、0603，无完整料号。确定耐压、介质和直流偏压后的有效电容，再给贴片厂最终物料表。5V线上可优先核对10V及以上的X5R/X7R具体型号。
- C14/C15目前仍是FIT，并未采纳上午提出的首版DNP建议。SYS_5V直接并联标称33.2uF未变。是否不装应在装配单上明确；若两颗均不装，名义公共电容为13.2uF，不含HUB_VDD33和各隔离输入侧电容。
- 不建议为新C口再无条件增加大电容。当前总电容、电缆和外设输入电容的插入冲击需一起测。

### 5.3 整机供电和主机状态

- F1～F4仍是JK-SMD0603-050L-6低阻版本，输入各自经过CH213K合路，接法未变。
- 四个下游口共用SYS_5V；增加一个接口没有增加可用电流。上午报告的低压余量、合路取电和共用短路影响仍适用，不能承诺每口500mA。
- 首轮可从整机含板载及全部外设约200mA以内的验证目标开始；该数是测试目标，不是已测额定值或USB合规供电承诺。
- 没有主机VBUS检测：另一台电脑给板子供电时，所选电脑端口断电后仍可能接着数据。首版按讨论保留此边界；按键操作不能自动识别选中主机之后的断电。
- 四路长期合路输入的供电授权、挂起电流和故障行为仍需验证，不能仅凭数据能识别就认为全部满足USB电气要求。

## 6. 切换控制和软件

本次未改变CH444G或MCU连接。PC6.16接MUX_SEL0，PC7.17接MUX_SEL1，PD2.19接MUX_EN_N。两位选择线独立，EN#有10k上拉，默认关闭数据。PD3～PD6接SW1～SW4；PC0～PC3接LED1～LED4，低电平点亮。H1仍为1 SWIO、2 NRST、3 GND。

增加Hub第4路外设无需修改按键选电脑的映射，Hub自行处理枚举。软件仍要先断开MUX、更新选择、等待稳定后再接通，避免直接带使能翻转选择位。LED只表示所选通道，不能代表外设已成功枚举。空白MCU没有切换功能，样板首次识别前需烧录固件。

## 7. 新增接口样板验收

1. 先用已知5V限流电源检查静态电流、SYS_5V和HUB_VDD33，再连接电脑。
2. USB8接已知低功耗USB2.0外设，用普通USB2.0 C-C线正反插分别检查识别和工作；不能只测一个方向。
3. USB8与三个USB-A同时连接低功耗外设，逐一确认四个Hub端口，检查四台电脑的所有目标切换。
4. 用实际线缆记录满载电流和最低SYS_5V/插座VBUS，检查插拔、切换和供电电脑退出时有无复位。
5. 检查选中主机USB供电关闭、其他主机仍供电的情况，记录反向电流/异常供电；不以“关机但VBUS仍有5V”代替此测试。
6. Type-C常供电方案的误接其他电源场景，如需验证，应使用可控限流台架，不用电脑端口作为短路或电源对冲的测试源。

## 8. 当前资料与范围

- [当前原理图PDF](SCH_SCH_new_2026-10-29.pdf)
- [当前BOM](BOM_SimpleKVM_new_SCH_new_2026-10-29.xlsx)
- [当前可编辑工程](ProPrj_SimpleKVM_2026-10-29.epro2)
- [上午供电计算和整体方案复核](12_投板前审查与方案复核_2026-10-21.md)：历史输入为10:47版本。

2026-10-29版仍保留3个USB-A和1个USB-C独立下游口，R21/R22为56kΩ，USB8常供电边界不变。当前没有同版本ENET网表，不能沿用本报告的历史自动检查数量宣称新版已通过网表验证；PCB还需在EDA中执行ERC/DRC、封装和差分线检查。
