luoyanglutu-pixel/SimpleKVM/结构设计/外观渲染/2026-10-23_烟灰半透方案_v1.png

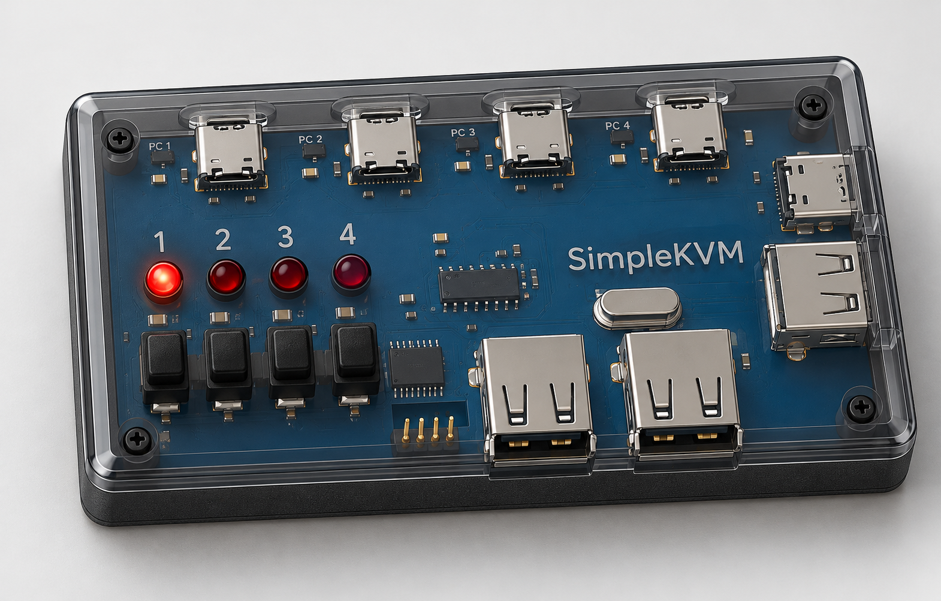
结构设计/外观渲染/2026-10-23_烟灰半透方案_v1.png
