luoyanglutu-pixel/SimpleKVM/软件设计/烧录工具.png

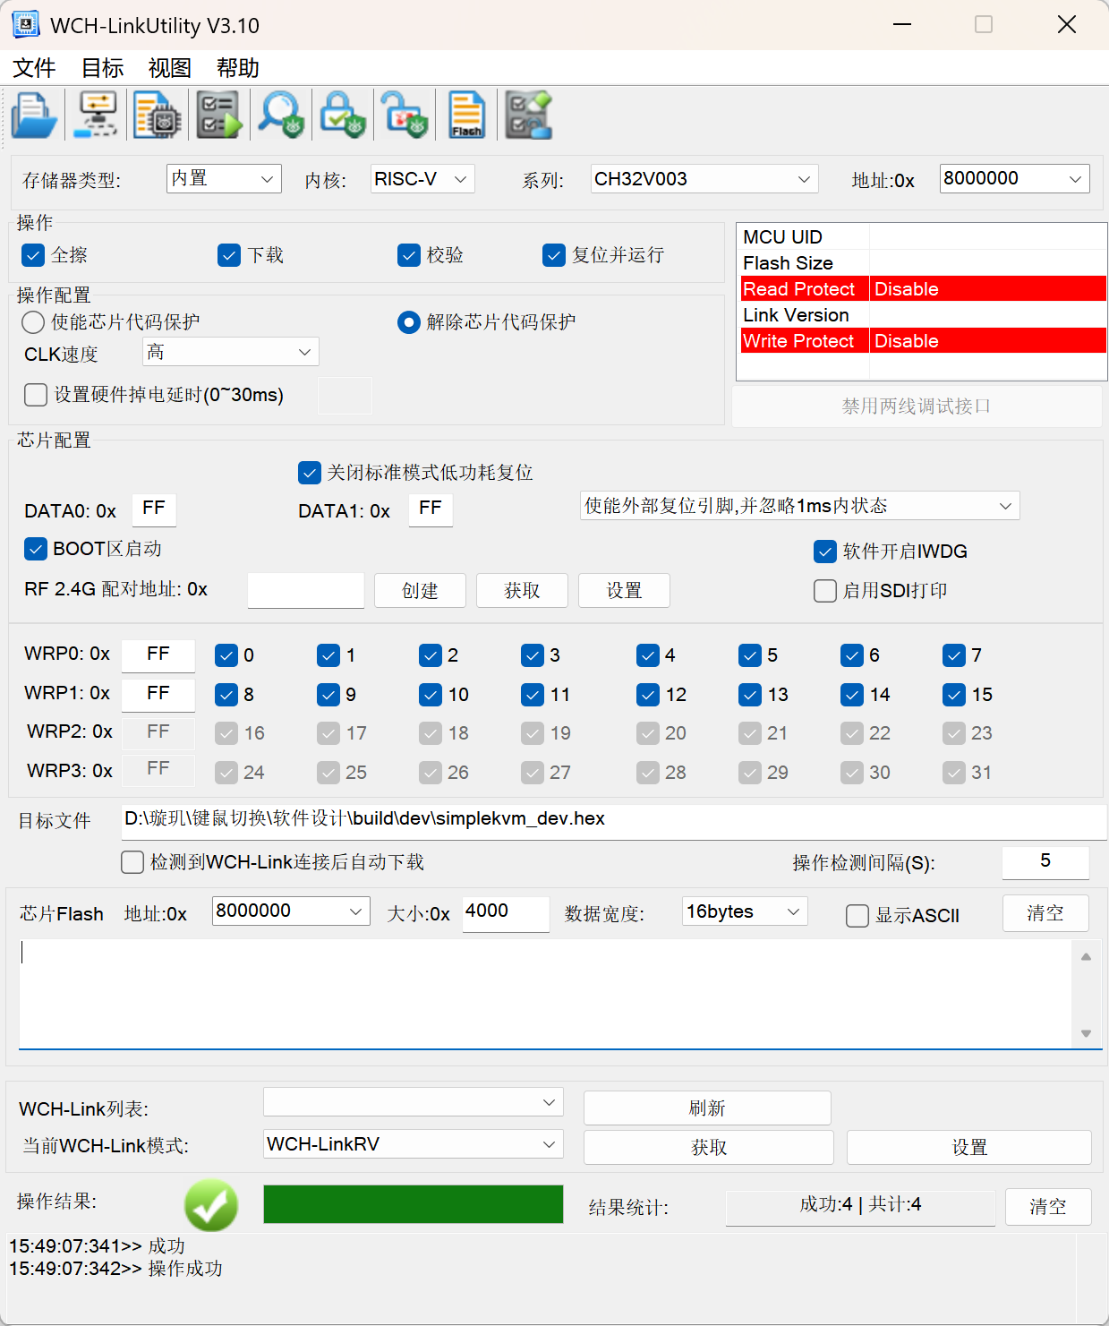
软件设计/烧录工具.png
