luoyanglutu-pixel/SimpleKVM/硬件设计/BOM_SimpleKVM_new_SCH_new_2026-10-29.xlsx

No. | Quantity | Comment | Designator | Footprint | Value | Manufacturer Part | Manufacturer | Supplier Part | Supplier | Add into BOM
1 | 1 | 10uF | C1 | C0402 | 10uF | CGA0402X5R106M6R3GT | HRE(芯声) | C23692971 | LCSC | yes
2 | 4 | 1uF | C2,C12,C13,C16 | C0402 | 1uF | CL05A105KO5NNNC | SAMSUNG(三星) | C29266 | LCSC | yes
3 | 2 | 100nF | C3,C11 | C0402 | 100nF | FCC0402B104K160AT | FOJAN(富捷) | C5137468 | LCSC | yes
4 | 6 | 10uF | C4,C5,C7,C9,C10,C14 | C0603 | 10uF | CGA0603X5R106K100JT | HRE(芯声) | C6119842 | LCSC | yes
5 | 4 | JK-SMD0603-050L-6 | F1,F2,F3,F4 | F0603 |  | JK-SMD0603-050L-6 | JK(金科) | C5224376 | LCSC | yes
6 | 1 | LAIL-PZ2.54-3P-L | H1 | HDR-TH_3P-P2.54-V-M-1 |  | LAIL-PZ2.54-3P-L | LAILAN(莱联) | C54950604 | LCSC | yes
7 | 1 | CH444G | KEY1 | SOP-16_L10.0-W3.9-P1.27-LS6.0-BL |  | CH444G | WCH(南京沁恒) | C86413 | LCSC | yes
8 | 4 | XL-502SURD | LED1,LED2,LED3,LED4 | LED-TH_BD5.9-P2.54-RD_RED |  | XL-502SURD | XINGLIGHT(成兴光) | C2895492 | LCSC | yes
9 | 4 | 4.7kΩ | R5,R6,R7,R8 | R0402 | 4.7kΩ | 0402WGJ0472TCE | UNI-ROYAL(厚声) | C25940 | LCSC | yes
10 | 2 | 10kΩ | R9,R12 | R0402 | 10kΩ | FRC0402J103 TS | FOJAN(富捷) | C2906885 | LCSC | yes
11 | 2 | 100kΩ | R10,R11 | R0402 | 100kΩ | 0402WGF1003TCE | UNI-ROYAL(厚声) | C25741 | LCSC | yes
12 | 8 | 5.1kΩ | R13,R14,R15,R16,R17,R18,R19,R20 | R0402 | 5.1kΩ | FRC0402F5101TS | FOJAN(富捷) | C2906874 | LCSC | yes
13 | 2 | 56kΩ | R21,R22 | R0402 | 56kΩ | FRC0402F5602TS | FOJAN(富捷) | C2906875 | LCSC | yes
14 | 4 | TS-1101-C-W | SW1,SW2,SW3,SW4 | SW-SMD_L6.0-W3.3-LS8.0 |  | TS-1101-C-W | XKB Connectivity(中国星坤) | C318938 | LCSC | yes
15 | 4 | CH213K | U1,U2,U3,U4 | SOT-23-3_L2.9-W1.6-P1.90-LS2.8-BR |  | CH213K | WCH(南京沁恒) | C5456874 | LCSC | yes
16 | 1 | CH334P | U6 | QFN-16_L3.0-W3.0-P0.50-BL-EP1.7 |  | CH334P | WCH(南京沁恒) | C5373042 | LCSC | yes
17 | 1 | CH32V003F4P6 | U8 | TSSOP-20_L6.5-W4.4-P0.65-LS6.4-BL |  | CH32V003F4P6 | WCH(南京沁恒) | C5187096 | LCSC | yes
18 | 5 | KH-TYPE-C-16P | USB1,USB2,USB3,USB4,USB8 | USB-C-SMD_KH-TYPE-C-16P |  | KH-TYPE-C-16P | kinghelm(金航标) | C709357 | LCSC | yes
19 | 3 | USB-231-ARY | USB5,USB6,USB7 | USB-A-TH_USB-231-ARY |  | USB-231-ARY | XUNPU(讯普) | C720525 | LCSC | yes
20 | 1 | 12MHz | X1 | HC-49US_L11.5-W4.5-P4.88 | 12MHz | X49SD12MSD2SC | YXC(扬兴晶振) | C16369 | LCSC | yes
