luoyanglutu-pixel/SimpleKVM/结构设计/打印件/按键2-4.3mf

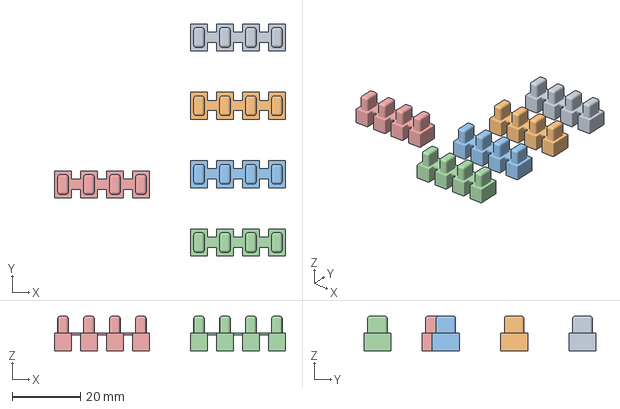
[picture p5: CAD file, 2026-10-30]
结构设计/打印件/按键2-4.3mf
67.6 x 68.0 x 10.2 mm
按键2-4 x 5
