luoyanglutu-pixel/SimpleKVM/结构设计/按键2.SLDPRT

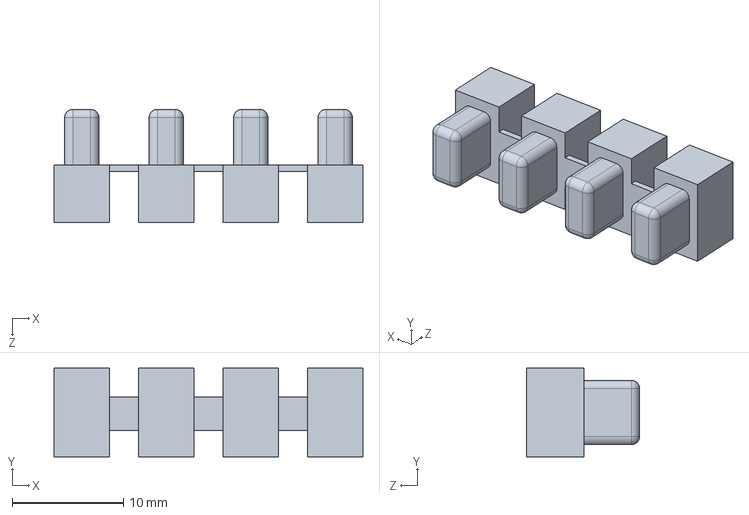
[picture p6: CAD file, 2026-10-30]
结构设计/按键2.SLDPRT
27.8 x 8.00 x 10.2 mm
