luoyanglutu-pixel/SimpleKVM/结构设计/打印件/后盖.3mf

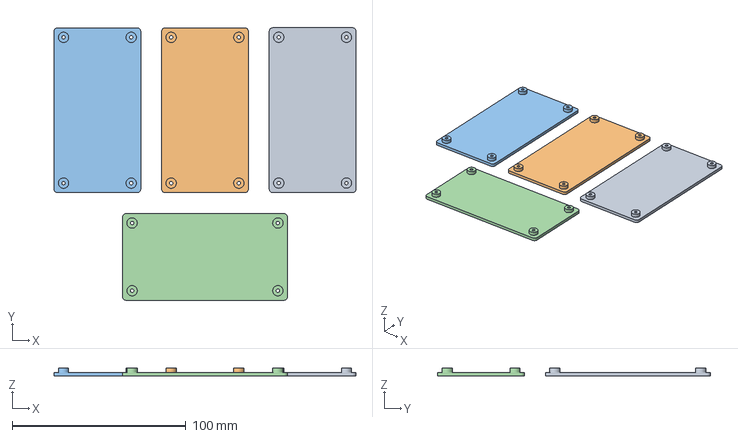
[picture p7: CAD file, 2026-10-30]
结构设计/打印件/后盖.3mf
174.0 x 157.0 x 4.40 mm
后盖 x 4
