luoyanglutu-pixel/SimpleKVM/结构设计/打印件/上壳-3.3MF

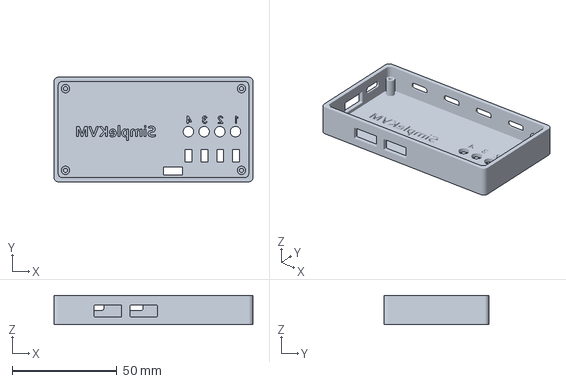
[picture p8: CAD file, 2026-10-30]
结构设计/打印件/上壳-3.3MF
95.0 x 50.0 x 14.0 mm
