luoyanglutu-pixel/SimpleKVM/结构设计/后盖.SLDPRT

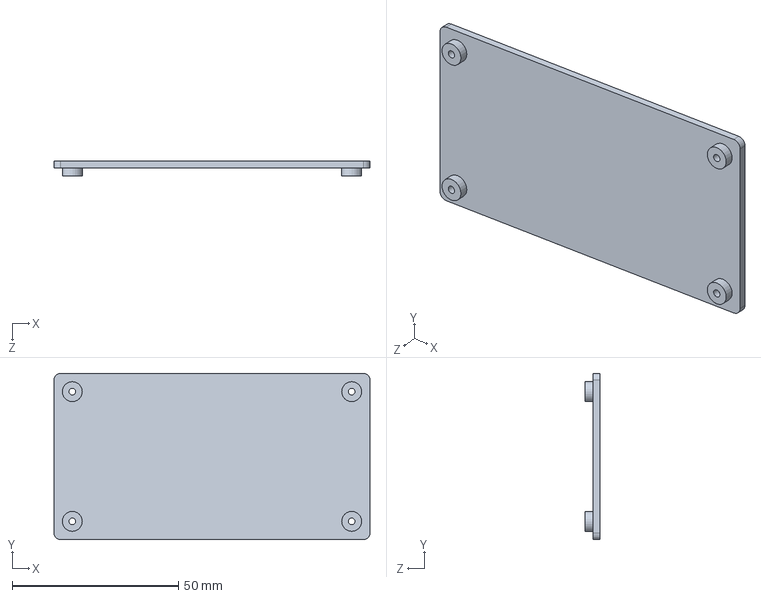
[picture p9: CAD file, 2026-10-30]
结构设计/后盖.SLDPRT
95.0 x 50.0 x 4.40 mm
