luoyanglutu-pixel/SimpleKVM/结构设计/按键.SLDPRT

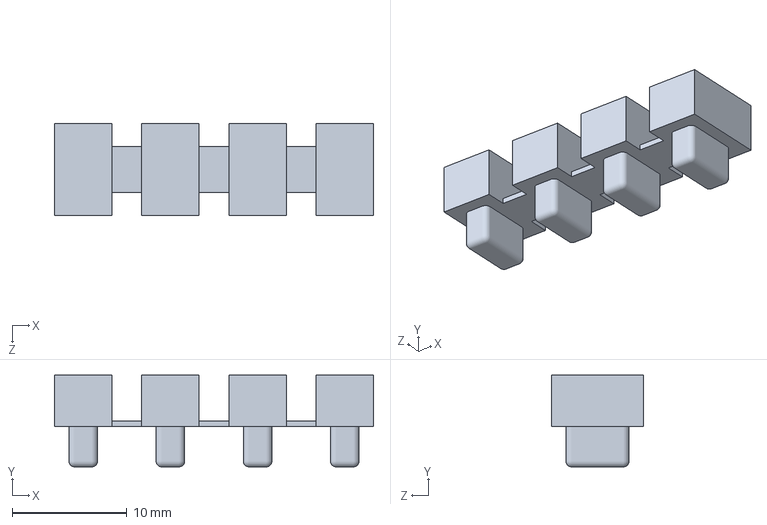
[picture p10: CAD file, 2026-10-30]
结构设计/按键.SLDPRT
27.8 x 8.00 x 8.00 mm
