luoyanglutu-pixel/SimpleKVM/结构设计/3D_PCB_new_2026-10-21-2.SLDASM

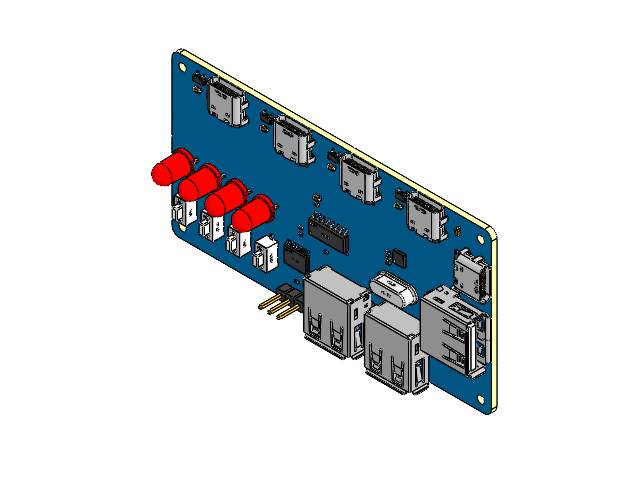
[picture p11: CAD file, 2026-10-30]
结构设计/3D_PCB_new_2026-10-21-2.SLDASM
SW-SMD_L6.0-W3.3-LS8.0~SW-SMD_L6.0-W3.3-H5-LS8.0~tEpN x 4
R0402~R0402_L1.0-W0.5-H0.4~vs6t x 18
F0603~F0603_L1.7-W0.9-H0.7~g1mN x 4
HC-49US_L11.5-W4.5-P4.88~HC-49US_L11.0-W4.5-H3.5-P4.88~ZOxU
SOT-23-3_L2.9-W1.6-P1.90-LS2.8-BR~SOT-23-3L_L2.9-W1.6-H1.1-LS2.8-P0.95~LwXP x 4
USB-A-TH_USB-231-ARY~USB-A-TH_USB-231-ARY~8kNw x 3
C0603~C0603_L1.6-W0.8-H0.8~1t0g x 6
QFN-16_L3.0-W3.0-P0.50-BL-EP1.7~QFN-16_L3.0-W3.0-P0.50-EP1.7~LeOl
LED-TH_BD5.9-P2.54-RD_RED~LED-TH_BD5.9-P2.54-RD_RED~ss2j x 4
USB-C-SMD_KH-TYPE-C-16P~USB-C-SMD_KH-TYPE-C-16P~kFVh x 5
C0402~C0402_L1.0-W0.5-H0.5~99fW x 7
SOP-16_L10.0-W3.9-P1.27-LS6.0-BL~SOP-16_L9.9-W3.9-H1.5-LS6.0-P1.27~DKr0
TSSOP-20_L6.5-W4.4-P0.65-LS6.4-BL~TSSOP-20_L6.5-W4.4-H1.0-LS6.4-P0.65~yzmk
HDR-TH_3P-P2.54-V-M-1~HDR-M-2.54_1x3~fDjF
Board~ZAn6
