luoyanglutu-pixel/SimpleKVM/(list of files, cad)

Other CAD files:
结构设计/R15~R0402~R0402_L1.0-W0.5-H0.4~Mk1Y.SLDASM
结构设计/USB2~USB-C-SMD_KH-TYPE-C-16P~USB-C-SMD_KH-TYPE-C-16P~6KkB.SLDASM
结构设计/C16~C0402~C0402_L1.0-W0.5-H0.5~f0AC.SLDASM
结构设计/USB5~USB-A-TH_USB-231-ARY~USB-A-TH_USB-231-ARY~lpIa.SLDASM
结构设计/USB1~USB-C-SMD_KH-TYPE-C-16P~USB-C-SMD_KH-TYPE-C-16P~4Yo5.SLDASM
结构设计/USB4~USB-C-SMD_KH-TYPE-C-16P~USB-C-SMD_KH-TYPE-C-16P~wJAR.SLDASM
结构设计/SW4~SW-SMD_L6.0-W3.3-LS8.0~SW-SMD_L6.0-W3.3-H5-LS8.0~KRGj.SLDASM
结构设计/R7~R0402~R0402_L1.0-W0.5-H0.4~jRob.SLDASM
结构设计/U1~SOT-23-3_L2.9-W1.6-P1.90-LS2.8-BR~SOT-23-3L_L2.9-W1.6-H1.1-LS2.8-P0.95~h07N.SLDASM
结构设计/U1~SOT-23-3_L2.9-W1.6-P1.90-LS2.8-BR~SOT-23-3L_L2.9-W1.6-H1.1-LS2.8-P0.95~oc9o.SLDASM
结构设计/SW3~SW-SMD_L6.0-W3.3-LS8.0~SW-SMD_L6.0-W3.3-H5-LS8.0~NgkM.SLDASM
结构设计/C10~C0603~C0603_L1.6-W0.8-H0.8~5WEk.SLDASM
结构设计/U2~SOT-23-3_L2.9-W1.6-P1.90-LS2.8-BR~SOT-23-3L_L2.9-W1.6-H1.1-LS2.8-P0.95~8RNj.SLDASM
结构设计/C4~C0603~C0603_L1.6-W0.8-H0.8~SFEg.SLDASM
结构设计/C9~C0603~C0603_L1.6-W0.8-H0.8~Vhv4.SLDASM
结构设计/R10~R0402~R0402_L1.0-W0.5-H0.4~zMvN.SLDASM
结构设计/R9~R0402~R0402_L1.0-W0.5-H0.4~ciY3.SLDASM
结构设计/SW4~SW-SMD_L6.0-W3.3-LS8.0~SW-SMD_L6.0-W3.3-H5-LS8.0~G9xv.SLDASM
结构设计/LED4~LED-TH_BD5.9-P2.54-RD_RED~LED-TH_BD5.9-P2.54-RD_RED~RTlF.SLDASM
结构设计/C3~C0402~C0402_L1.0-W0.5-H0.5~UTAG.SLDASM
结构设计/C9~C0603~C0603_L1.6-W0.8-H0.8~mpdT.SLDASM
结构设计/LED1~LED-TH_BD5.9-P2.54-RD_RED~LED-TH_BD5.9-P2.54-RD_RED~ks6z.SLDASM
结构设计/F3~F0603~F0603_L1.7-W0.9-H0.7~pWZu.SLDASM
结构设计/R22~R0402~R0402_L1.0-W0.5-H0.4~xw4L.SLDASM
结构设计/F3~F0603~F0603_L1.7-W0.9-H0.7~hz1r.SLDASM
结构设计/USB6~USB-A-TH_USB-231-ARY~USB-A-TH_USB-231-ARY~NJIn.SLDASM
结构设计/LED2~LED-TH_BD5.9-P2.54-RD_RED~LED-TH_BD5.9-P2.54-RD_RED~mCTE.SLDASM
结构设计/C1~C0402~C0402_L1.0-W0.5-H0.5~w8gj.SLDASM
结构设计/R6~R0402~R0402_L1.0-W0.5-H0.4~uKcQ.SLDASM
结构设计/R18~R0402~R0402_L1.0-W0.5-H0.4~QBOr.SLDASM
结构设计/R16~R0402~R0402_L1.0-W0.5-H0.4~nJ3J.SLDASM
结构设计/C10~C0603~C0603_L1.6-W0.8-H0.8~rkph.SLDASM
结构设计/U2~SOT-23-3_L2.9-W1.6-P1.90-LS2.8-BR~SOT-23-3L_L2.9-W1.6-H1.1-LS2.8-P0.95~oRds.SLDASM
结构设计/R21~R0402~R0402_L1.0-W0.5-H0.4~6wJi.SLDASM
结构设计/USB3~USB-C-SMD_KH-TYPE-C-16P~USB-C-SMD_KH-TYPE-C-16P~0qxR.SLDASM
结构设计/R5~R0402~R0402_L1.0-W0.5-H0.4~QqrG.SLDASM
结构设计/U3~SOT-23-3_L2.9-W1.6-P1.90-LS2.8-BR~SOT-23-3L_L2.9-W1.6-H1.1-LS2.8-P0.95~G0EF.SLDASM
结构设计/R13~R0402~R0402_L1.0-W0.5-H0.4~54k0.SLDASM
结构设计/U3~SOT-23-3_L2.9-W1.6-P1.90-LS2.8-BR~SOT-23-3L_L2.9-W1.6-H1.1-LS2.8-P0.95~IqSz.SLDASM
结构设计/SW2~SW-SMD_L6.0-W3.3-LS8.0~SW-SMD_L6.0-W3.3-H5-LS8.0~1iAI.SLDASM
结构设计/R13~R0402~R0402_L1.0-W0.5-H0.4~K385.SLDASM
结构设计/USB3~USB-C-SMD_KH-TYPE-C-16P~USB-C-SMD_KH-TYPE-C-16P~dLpj.SLDASM
结构设计/KEY1~SOP-16_L10.0-W3.9-P1.27-LS6.0-BL~SOP-16_L9.9-W3.9-H1.5-LS6.0-P1.27~6zFk.SLDASM
结构设计/F4~F0603~F0603_L1.7-W0.9-H0.7~3dX5.SLDASM
结构设计/F1~F0603~F0603_L1.7-W0.9-H0.7~mhle.SLDASM
结构设计/C2~C0402~C0402_L1.0-W0.5-H0.5~vvmM.SLDASM
结构设计/U8~TSSOP-20_L6.5-W4.4-P0.65-LS6.4-BL~TSSOP-20_L6.5-W4.4-H1.0-LS6.4-P0.65~KmkT.SLDASM
结构设计/USB5~USB-A-TH_USB-231-ARY~USB-A-TH_USB-231-ARY~alls.SLDASM
结构设计/C14~C0603~C0603_L1.6-W0.8-H0.8~SMO3.SLDASM
结构设计/H1~HDR-TH_3P-P2.54-V-M-1~HDR-M-2.54_1x3~CO9q.SLDASM
结构设计/C3~C0402~C0402_L1.0-W0.5-H0.5~t6O6.SLDASM
结构设计/R20~R0402~R0402_L1.0-W0.5-H0.4~aCVg.SLDASM
结构设计/R21~R0402~R0402_L1.0-W0.5-H0.4~lzFh.SLDASM
结构设计/R8~R0402~R0402_L1.0-W0.5-H0.4~tLEF.SLDASM
结构设计/U6~QFN-16_L3.0-W3.0-P0.50-BL-EP1.7~QFN-16_L3.0-W3.0-P0.50-EP1.7~CkGg.SLDASM
结构设计/C12~C0402~C0402_L1.0-W0.5-H0.5~mP8y.SLDASM
结构设计/C7~C0603~C0603_L1.6-W0.8-H0.8~KDyo.SLDASM
结构设计/C14~C0603~C0603_L1.6-W0.8-H0.8~slNx.SLDASM
结构设计/X1~HC-49US_L11.5-W4.5-P4.88~HC-49US_L11.0-W4.5-H3.5-P4.88~fSye.SLDASM
结构设计/C2~C0402~C0402_L1.0-W0.5-H0.5~LIHj.SLDASM
结构设计/F2~F0603~F0603_L1.7-W0.9-H0.7~pZ2L.SLDASM
结构设计/LED1~LED-TH_BD5.9-P2.54-RD_RED~LED-TH_BD5.9-P2.54-RD_RED~42GK.SLDASM
结构设计/C5~C0603~C0603_L1.6-W0.8-H0.8~ZwYl.SLDASM
结构设计/R20~R0402~R0402_L1.0-W0.5-H0.4~phvp.SLDASM
结构设计/USB8~USB-C-SMD_KH-TYPE-C-16P~USB-C-SMD_KH-TYPE-C-16P~wZBs.SLDASM
结构设计/C11~C0402~C0402_L1.0-W0.5-H0.5~ylLN.SLDASM
结构设计/R15~R0402~R0402_L1.0-W0.5-H0.4~y31m.SLDASM
结构设计/USB1~USB-C-SMD_KH-TYPE-C-16P~USB-C-SMD_KH-TYPE-C-16P~ZMbW.SLDASM
结构设计/SW1~SW-SMD_L6.0-W3.3-LS8.0~SW-SMD_L6.0-W3.3-H5-LS8.0~1Ubp.SLDASM
结构设计/SW3~SW-SMD_L6.0-W3.3-LS8.0~SW-SMD_L6.0-W3.3-H5-LS8.0~pm53.SLDASM
结构设计/R22~R0402~R0402_L1.0-W0.5-H0.4~cpFK.SLDASM
结构设计/X1~HC-49US_L11.5-W4.5-P4.88~HC-49US_L11.0-W4.5-H3.5-P4.88~Dw9U.SLDASM
结构设计/SW1~SW-SMD_L6.0-W3.3-LS8.0~SW-SMD_L6.0-W3.3-H5-LS8.0~gVqL.SLDASM
结构设计/R11~R0402~R0402_L1.0-W0.5-H0.4~QPyE.SLDASM
结构设计/R14~R0402~R0402_L1.0-W0.5-H0.4~ExHE.SLDASM
结构设计/USB7~USB-A-TH_USB-231-ARY~USB-A-TH_USB-231-ARY~fJys.SLDASM
结构设计/R6~R0402~R0402_L1.0-W0.5-H0.4~6scx.SLDASM
结构设计/USB7~USB-A-TH_USB-231-ARY~USB-A-TH_USB-231-ARY~S4ZW.SLDASM
结构设计/F4~F0603~F0603_L1.7-W0.9-H0.7~bo7D.SLDASM
结构设计/U6~QFN-16_L3.0-W3.0-P0.50-BL-EP1.7~QFN-16_L3.0-W3.0-P0.50-EP1.7~1z99.SLDASM
结构设计/R17~R0402~R0402_L1.0-W0.5-H0.4~FPlr.SLDASM
结构设计/R17~R0402~R0402_L1.0-W0.5-H0.4~BsIf.SLDASM
结构设计/R12~R0402~R0402_L1.0-W0.5-H0.4~J1bf.SLDASM
结构设计/KEY1~SOP-16_L10.0-W3.9-P1.27-LS6.0-BL~SOP-16_L9.9-W3.9-H1.5-LS6.0-P1.27~cFsx.SLDASM
结构设计/C11~C0402~C0402_L1.0-W0.5-H0.5~FwcH.SLDASM
结构设计/USB4~USB-C-SMD_KH-TYPE-C-16P~USB-C-SMD_KH-TYPE-C-16P~9l2b.SLDASM
结构设计/R19~R0402~R0402_L1.0-W0.5-H0.4~QHIK.SLDASM
结构设计/R19~R0402~R0402_L1.0-W0.5-H0.4~rlDh.SLDASM
结构设计/U8~TSSOP-20_L6.5-W4.4-P0.65-LS6.4-BL~TSSOP-20_L6.5-W4.4-H1.0-LS6.4-P0.65~jGUO.SLDASM
结构设计/U4~SOT-23-3_L2.9-W1.6-P1.90-LS2.8-BR~SOT-23-3L_L2.9-W1.6-H1.1-LS2.8-P0.95~Ns4B.SLDASM
结构设计/C1~C0402~C0402_L1.0-W0.5-H0.5~fSrr.SLDASM
结构设计/R7~R0402~R0402_L1.0-W0.5-H0.4~DB2Q.SLDASM
结构设计/R16~R0402~R0402_L1.0-W0.5-H0.4~5Oi5.SLDASM
结构设计/R18~R0402~R0402_L1.0-W0.5-H0.4~mKDD.SLDASM
结构设计/F2~F0603~F0603_L1.7-W0.9-H0.7~aDkm.SLDASM
结构设计/C4~C0603~C0603_L1.6-W0.8-H0.8~K1RZ.SLDASM
结构设计/H1~HDR-TH_3P-P2.54-V-M-1~HDR-M-2.54_1x3~cMdt.SLDASM
结构设计/USB2~USB-C-SMD_KH-TYPE-C-16P~USB-C-SMD_KH-TYPE-C-16P~SlrR.SLDASM
结构设计/R9~R0402~R0402_L1.0-W0.5-H0.4~RuUb.SLDASM
结构设计/R8~R0402~R0402_L1.0-W0.5-H0.4~KQhQ.SLDASM
结构设计/R10~R0402~R0402_L1.0-W0.5-H0.4~5ztI.SLDASM
结构设计/LED4~LED-TH_BD5.9-P2.54-RD_RED~LED-TH_BD5.9-P2.54-RD_RED~DX9j.SLDASM
结构设计/LED3~LED-TH_BD5.9-P2.54-RD_RED~LED-TH_BD5.9-P2.54-RD_RED~Srio.SLDASM
结构设计/R5~R0402~R0402_L1.0-W0.5-H0.4~G0Fu.SLDASM
结构设计/R12~R0402~R0402_L1.0-W0.5-H0.4~jkI6.SLDASM
结构设计/C13~C0402~C0402_L1.0-W0.5-H0.5~C3K7.SLDASM
结构设计/C13~C0402~C0402_L1.0-W0.5-H0.5~ZjSb.SLDASM
结构设计/USB6~USB-A-TH_USB-231-ARY~USB-A-TH_USB-231-ARY~c2Qd.SLDASM
结构设计/C7~C0603~C0603_L1.6-W0.8-H0.8~OUji.SLDASM
结构设计/C16~C0402~C0402_L1.0-W0.5-H0.5~p1zw.SLDASM
结构设计/R11~R0402~R0402_L1.0-W0.5-H0.4~P3JT.SLDASM
结构设计/F1~F0603~F0603_L1.7-W0.9-H0.7~iBNG.SLDASM
结构设计/LED2~LED-TH_BD5.9-P2.54-RD_RED~LED-TH_BD5.9-P2.54-RD_RED~sqEj.SLDASM
结构设计/SW2~SW-SMD_L6.0-W3.3-LS8.0~SW-SMD_L6.0-W3.3-H5-LS8.0~rSDB.SLDASM
结构设计/LED3~LED-TH_BD5.9-P2.54-RD_RED~LED-TH_BD5.9-P2.54-RD_RED~tSrZ.SLDASM
结构设计/R14~R0402~R0402_L1.0-W0.5-H0.4~BUtr.SLDASM
结构设计/C12~C0402~C0402_L1.0-W0.5-H0.5~9zYj.SLDASM
结构设计/USB8~USB-C-SMD_KH-TYPE-C-16P~USB-C-SMD_KH-TYPE-C-16P~BCiX.SLDASM
结构设计/C5~C0603~C0603_L1.6-W0.8-H0.8~iIJs.SLDASM
结构设计/U4~SOT-23-3_L2.9-W1.6-P1.90-LS2.8-BR~SOT-23-3L_L2.9-W1.6-H1.1-LS2.8-P0.95~7KCi.SLDASM
结构设计/LED-TH_BD5.9-P2.54-RD_RED~LED-TH_BD5.9-P2.54-RD_RED~xMyO.SLDPRT
结构设计/SOP-16_L10.0-W3.9-P1.27-LS6.0-BL~SOP-16_L9.9-W3.9-H1.5-LS6.0-P1.27~dqVo.SLDPRT
结构设计/SOT-23-3_L2.9-W1.6-P1.90-LS2.8-BR~SOT-23-3L_L2.9-W1.6-H1.1-LS2.8-P0.95~LwXP.SLDPRT
结构设计/TSSOP-20_L6.5-W4.4-P0.65-LS6.4-BL~TSSOP-20_L6.5-W4.4-H1.0-LS6.4-P0.65~yzmk.SLDPRT
结构设计/USB-C-SMD_KH-TYPE-C-16P~USB-C-SMD_KH-TYPE-C-16P~2x02.SLDPRT
结构设计/QFN-16_L3.0-W3.0-P0.50-BL-EP1.7~QFN-16_L3.0-W3.0-P0.50-EP1.7~swqC.SLDPRT
结构设计/C0603~C0603_L1.6-W0.8-H0.8~QXJ7.SLDPRT
结构设计/SW-SMD_L6.0-W3.3-LS8.0~SW-SMD_L6.0-W3.3-H5-LS8.0~tEpN.SLDPRT
结构设计/SOT-23-3_L2.9-W1.6-P1.90-LS2.8-BR~SOT-23-3L_L2.9-W1.6-H1.1-LS2.8-P0.95~wrKe.SLDPRT
结构设计/C0402~C0402_L1.0-W0.5-H0.5~99fW.SLDPRT
结构设计/HDR-TH_3P-P2.54-V-M-1~HDR-M-2.54_1x3~cns4.SLDPRT
结构设计/QFN-16_L3.0-W3.0-P0.50-BL-EP1.7~QFN-16_L3.0-W3.0-P0.50-EP1.7~LeOl.SLDPRT
结构设计/F0603~F0603_L1.7-W0.9-H0.7~6j0L.SLDPRT
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
