luoyanglutu-pixel/SimpleKVM/硬件设计/SCH_SCH_new_2026-10-29.pdf

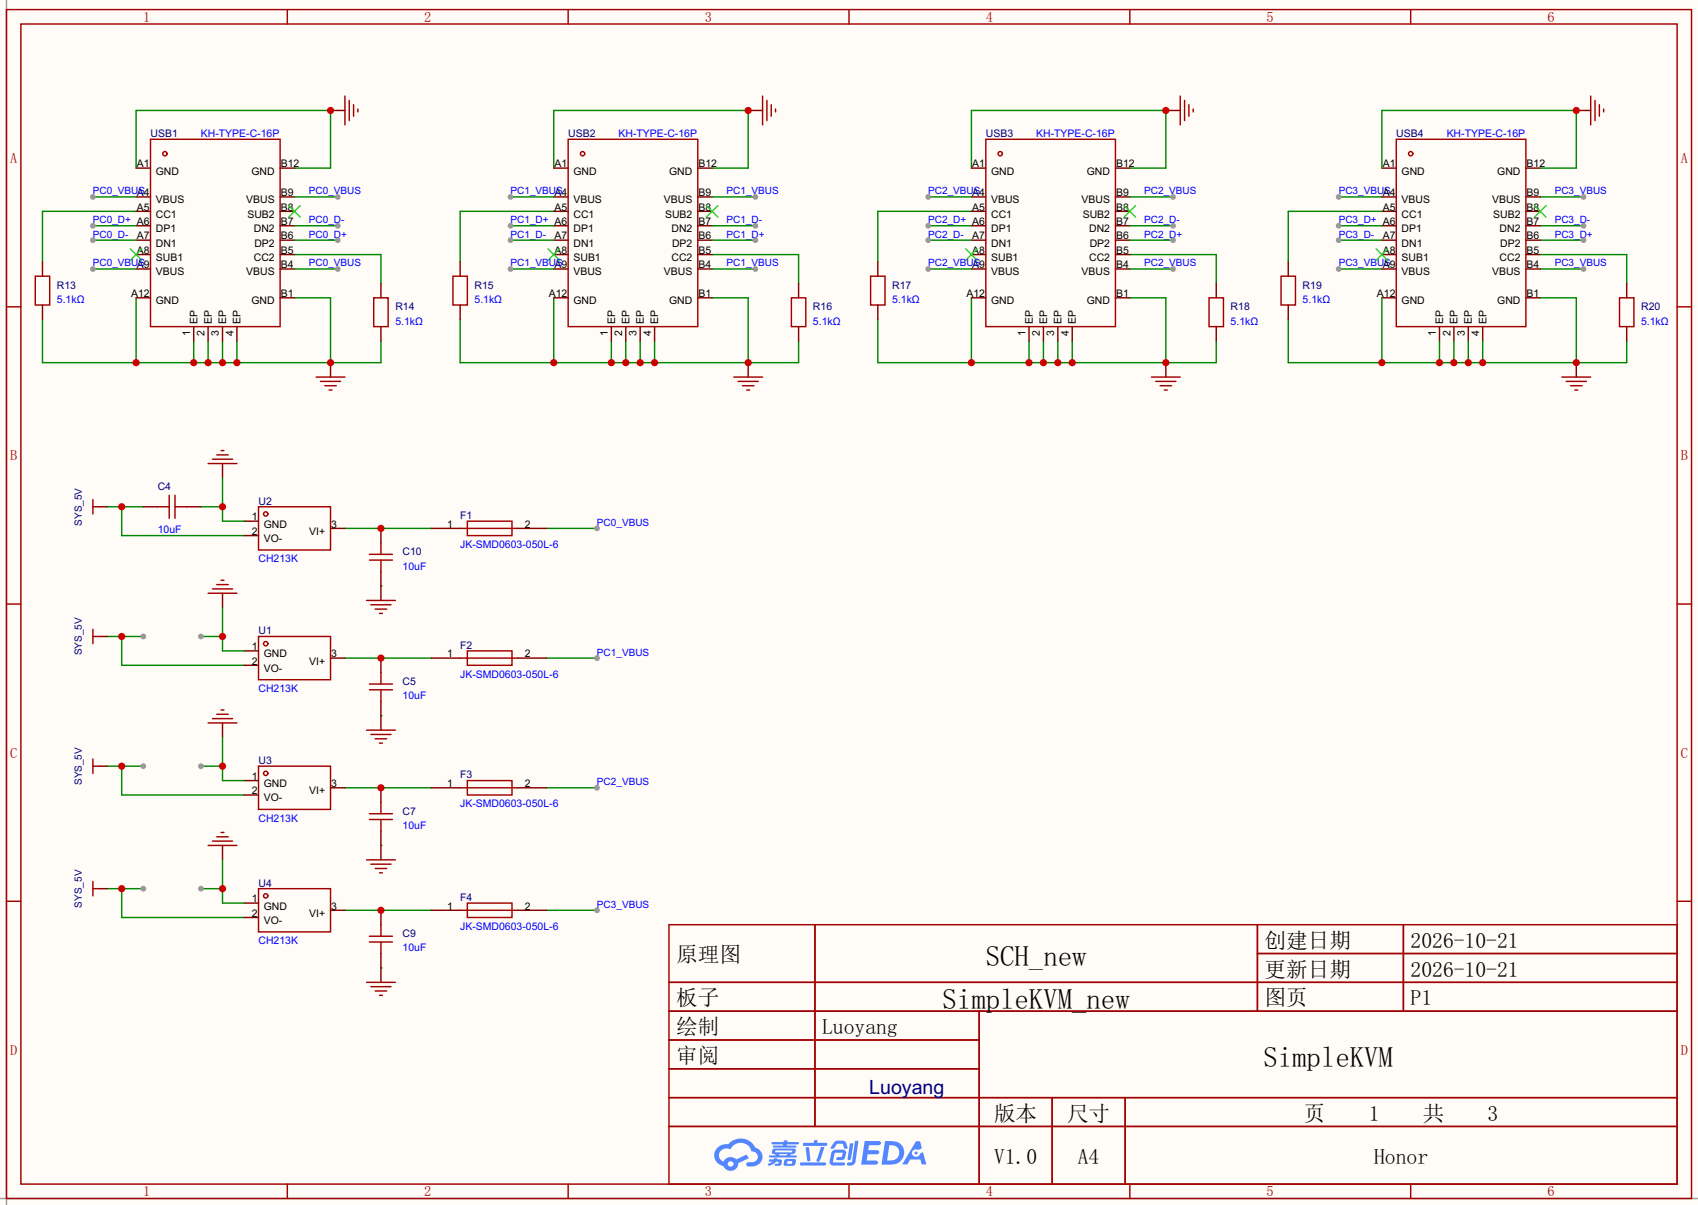
[picture p12: page 1]

原理图 | SCH_new | 创建日期 | 2026-10-21
板子 | SimpleKVM_new | 图页 | P1
绘制 | Luoyang | SimpleKVM
审阅

更新日期 | 2026-10-21

Luoyang

V1.0 | A4 | Honor

# S1B 10 S2B 11 S3B 12 S4B 13 IN0 14 NC 15 VCC 16

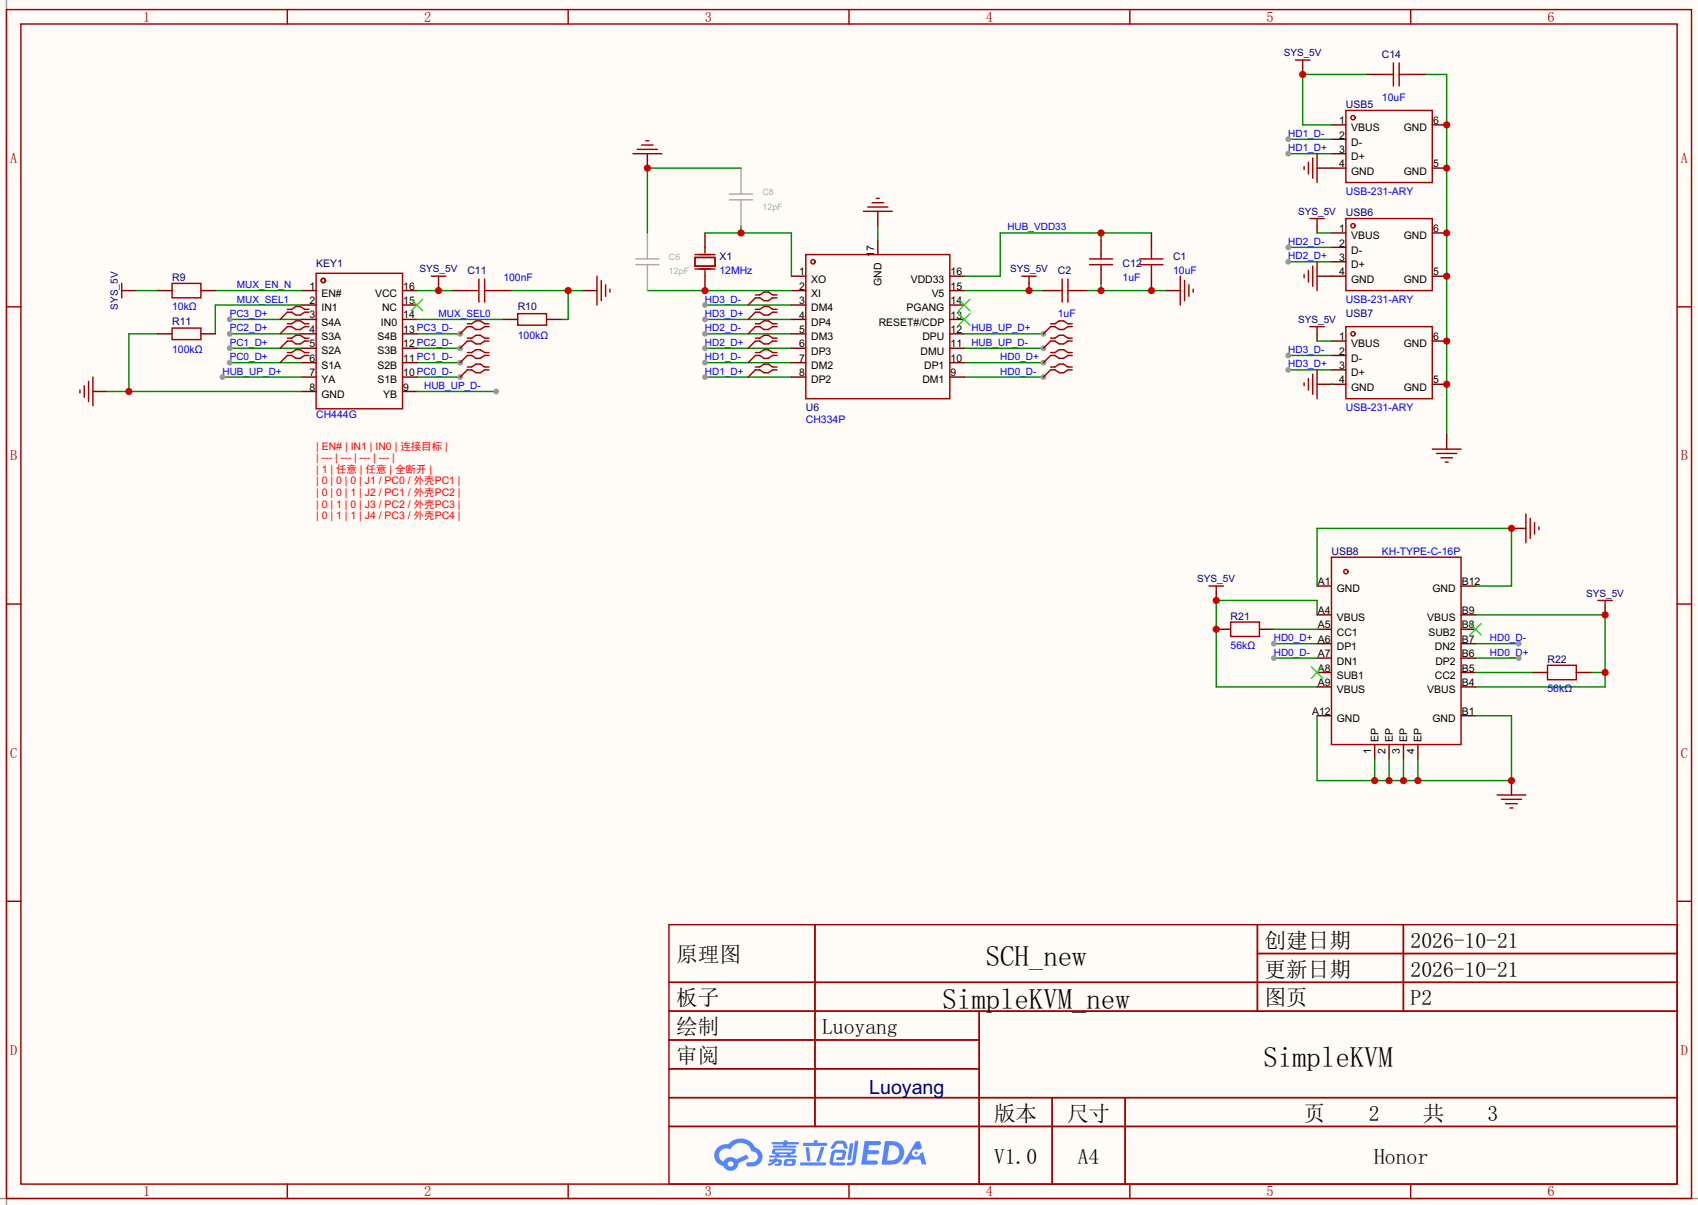
[picture p13: page 2]

原理图 | SCH_new | 创建日期 | 2026-10-21
板子 | SimpleKVM_new | 图页 | P2
绘制 | Luoyang | SimpleKVM
审阅

更新日期 | 2026-10-21

Luoyang

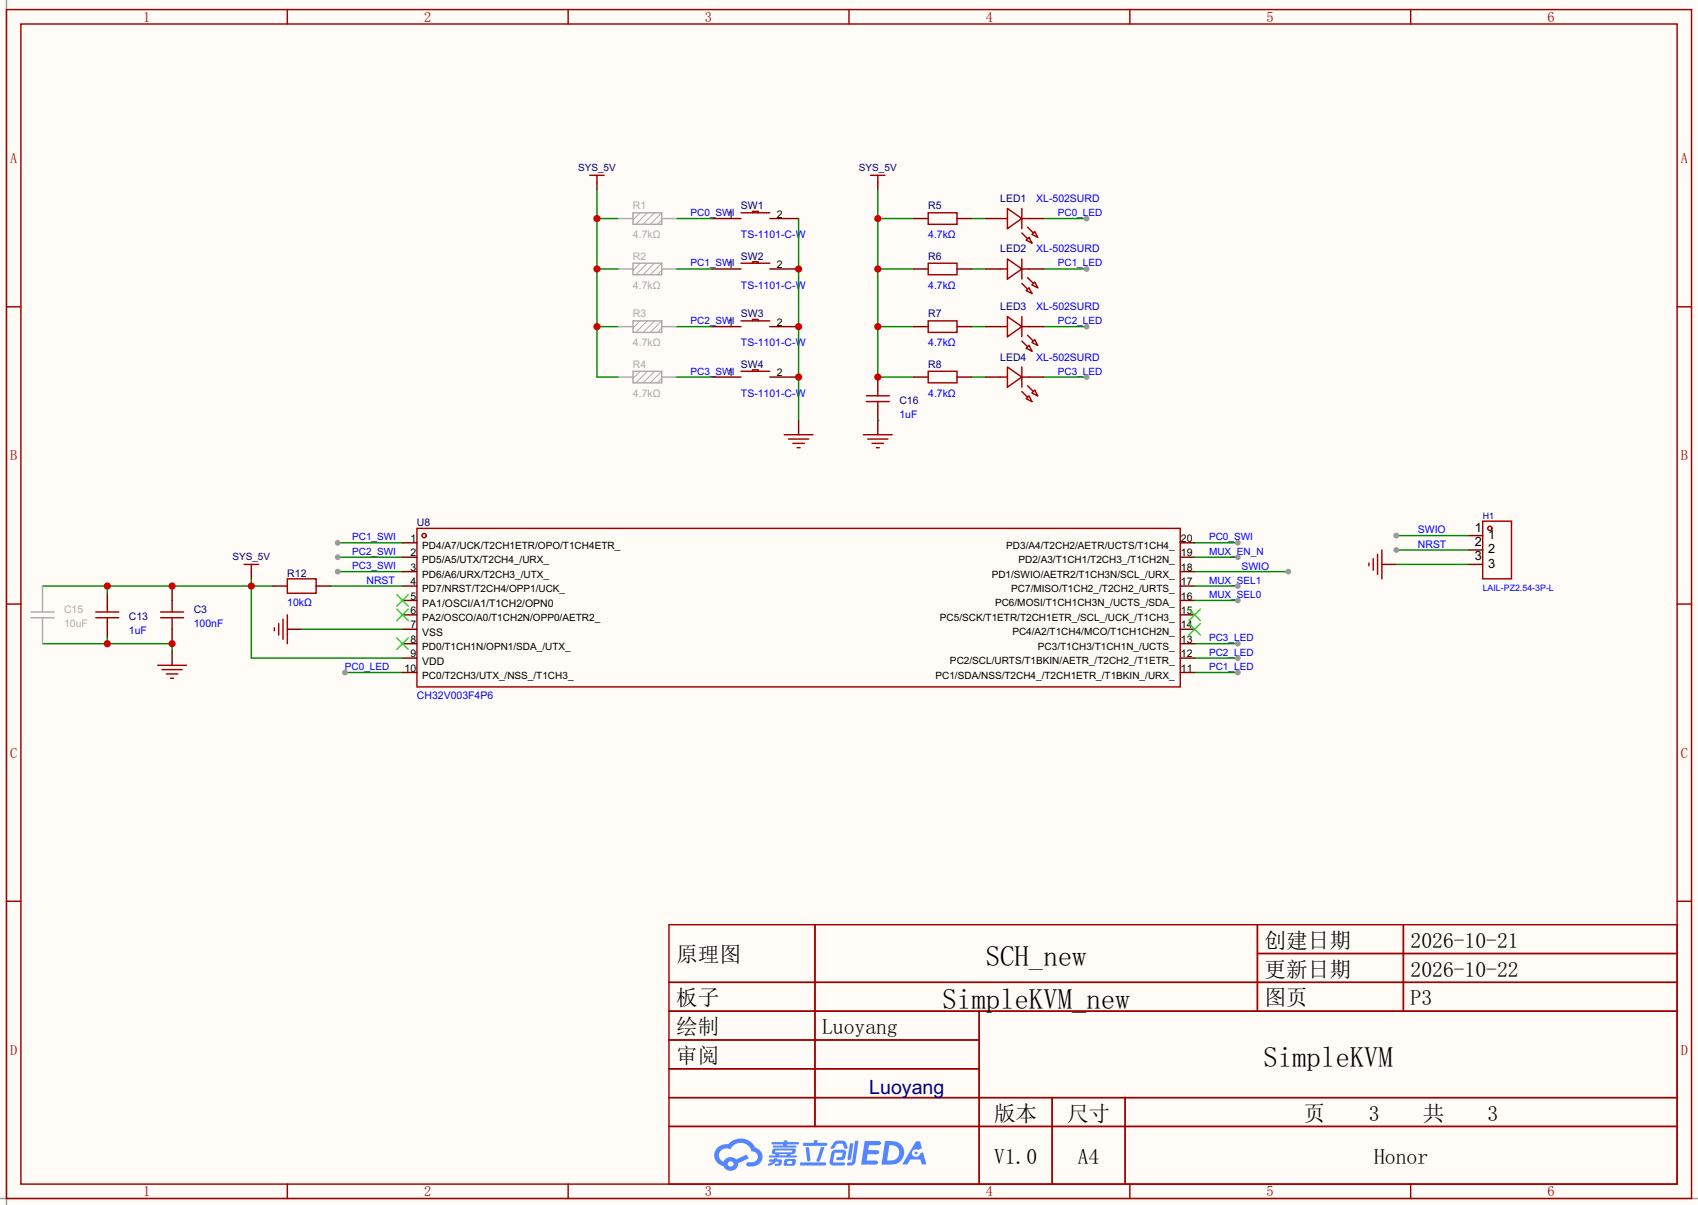
[picture p14: page 3]

原理图 | SCH_new | 创建日期 | 2026-10-21
板子 | SimpleKVM_new | 图页 | P3
绘制 | Luoyang | SimpleKVM
审阅

更新日期 | 2026-10-22

Luoyang
